vishakhkumar/HyTechAero/README.md

# HyTechAero

Files for HyTech Racing Aero/Composites Team.
For more information, contact me at vkumar@gatech.edu
