vishakhkumar/HyTechAero/3 MeetingNotes/KickoffMeeting.org

# -*- mode: org; -*-

#+TITLE: HyTech Racing Information
#+AUTHOR: Vishakh Pradeep Kumar
#+EMAIL: vkumar@gatech.edu
#+OPTIONS: num:10 whn:10 toc:5 H:100 *:yes ::yes \n:yes ^:yes |:yes

#+HTML_HEAD: <link rel="stylesheet" type="text/css" href="http://www.pirilampo.org/styles/readtheorg/css/htmlize.css"/>
#+HTML_HEAD: <link rel="stylesheet" type="text/css" href="http://www.pirilampo.org/styles/readtheorg/css/readtheorg.css"/>

#+HTML_HEAD: <script src="https://ajax.googleapis.com/ajax/libs/jquery/2.1.3/jquery.min.js"></script>
#+HTML_HEAD: <script src="https://maxcdn.bootstrapcdn.com/bootstrap/3.3.4/js/bootstrap.min.js"></script>
#+HTML_HEAD: <script type="text/javascript" src="http://www.pirilampo.org/styles/lib/js/jquery.stickytableheaders.js"></script>
#+HTML_HEAD: <script type="text/javascript" src="http://www.pirilampo.org/styles/readtheorg/js/readtheorg.js"></script>

* HyTech Racing 
** Location
575 14th St NW, Atlanta, GA 30318.
Google Maps Link -> https://www.google.com/maps/dir//33.786886,-84.406198/@33.786886,-84.406198,17z?hl=en-US

Org sync - apparently used for using rooms. Replaces Jacket pages.

*** Time required to walk to location.
Takes approximately 16 minutes to walk from Woodruff Hall
Takes approximately 23 minutes to walk from Howey Physics Building
You can ask for rides on Slack.

*** Official Address 
575 14th St NW
Atlanta, GA 30318
(850) 888-3232
gthytech@gmail.com
** Jacket Pages (Outdated) - http://jacketpages.gatech.edu/organizations/view/44686
*** Officers
| Jeffrey Ding	  | Team Lead (President) |
| Ayush Jha       | 	Treasurer           |
| Jonathan Rogers | Advisor               |
*** Description
HyTech Racing is a student team at the Georgia Institute of Technology that formed with the intent of competing at the Formula Hybrid International Competition.
The annual Formula Hybrid International Competition is an offshoot from the prestigious Formula SAE Competition.
Hosted by Dartmouth College, it has been held five times starting in 2007 at the New Hampshire Motor Speedway.
From late April to early May, teams from educational institutions around the world bring plug-in hybrid-electric, open-wheeled vehicles to perform in a variety of design and performance challenges.
Design, Endurance, Autocross, and Acceleration events emphasize the importance of a balance between performance and efficiency.
Our team formed in October of 2011 with a daunting goal in mind: to design, build, and test a hybrid vehicle in less than seven months.
In order to accomplish this goal, we apply knowledge learned in the classroom to produce a high-performance, fuel-efficient machine.
The design and build of a HyTech vehicle represents a vastly interdisciplinary process that will test our members on many levels.
The knowledge and skill set that we can gain through a hands-on project will improve our ability to add value to any organizations we become a part of in the future.
We have a designated office and prime warehouse space in Georgia Tech’s Student Competition Center where we will design and build our vehicle.

The primary objectives for HyTech Racing are as follows: 
- Provide hands-on engineering and organizational experience 
- Allow students to seek creative solutions for performance and efficiency in motor vehicles 
- Produce a competitive hybrid vehicle for the team’s first event that can be improved in coming years

*** Description Details
- Tier: III
- Organization Contact: Jeffrey Ding
- External Website: http://hytechracing.gatech.edu
- Meetings: Tuesday & Thursdays @ 6:30pm, Sundays @ 4pm
- Dues: $50 per semester

** OrgSync - https://orgsync.com/136388/chapter
*** Portal Information
**** Description
We are an award-winning electric vehicle racing team at Georgia Tech.
We participate in the annual Formula Hybrid (Electric Class) and FSAE Electric competitions which take place in Loudon, New Hampshire and Lincoln, Nebraska respectively.
Designing the car, working with a team, learning manufacturing tools and techniques techniques, and innovating with new technologies are all part of the experience!
Our core values are Innovation, Sustainability, Education, and Excellence.

**** Category
Recreation/Leisure
**** Website
http://hytechracing.gatech.edu/
**** Primary Student Organization Leader Position Title
Team President
**** Primary Student Organization Leader
Jeff Ding
***** Georgia Tech Email
jeffding@gatech.edu
**** Finance Officer Title
Treasurer
**** Finance Officer Name
Mike Yan
***** Georgia Tech Email
mike.yan@gatech.edu
**** Selection Process/Membership Requirements
To become a member of HyTech Racing, we ask that you:
- come to the meetings
- pay dues ($50 / semester)
- receive appropriate training
- and show a healthy interest in what we do!
**** Meeting Day
Sunday, Tuesday and Thursday
**** What are three goals your organization has for this year?
- Win our competitions 
- Be a good learning experience for new members 
- Start early on next year's car and improve upon this year's car

** Old Website - http://dcaplan3.wixsite.com/hytech-racing/about_us
*** The Competition
The way we move around the world is changing.  
As global warming, diminishing petroleum resources, and air pollution make traditional internal combustion vehicles less attractive every day, the race for effective solutions is on.
To foster learning and creative processes toward this problem, international educational institutions and corporations alike are promoting unique challenges that encourage students to design and build modern vehicles.
SAE International is perhaps the most important agent in promoting such challenges.

The annual Formula Hybrid International Competition is an offshoot from the prestigious Formula SAE Competition.
Hosted by Dartmouth College, it has been held every year since its founding in 2006 at the New Hampshire Motor Speedway.
In late April to early May, teams from educational institutions around the world bring plug-in hybrid-electric, open-wheeled vehicles to perform in a variety of design and performance challenges.
Design, Endurance, Autocross, and Acceleration events emphasize the importance of a balance between performance and efficiency.
*** Who We Are
HyTech Racing is Georgia Tech’s first and only team created to participate in the Formula Hybrid Competition.
Our team’s formation began with the election of a Project Lead and Chief Engineer on September 28, 2011.
Our goal is to address the challenges presented by the competition while learning how to design, build, and optimize advanced machines.
We also embrace the opportunity to gain experience in leadership, communication, business development, and effective time management throughout the course of the project.

The design and build of a “HyTech” vehicle represents a vastly interdisciplinary process that will test our members on many levels, and make them more prepared to face real-world challenges in the workplace after graduation.
The knowledge and skill set that we can gain through a hands-on project where a student-run group acts as an entire business unit will improve our ability to add value to whatever organizations we may become a part of in the future.
While an education in the classroom is necessary, an education in this team environment can teach us lessons far beyond the scope of traditional learning.

We have a designated workplace in Georgia Tech’s new, coveted Student Competition Center, with plenty of space and resources to design and build our vehicle inside prime warehouse space and our private office.
Other Georgia Tech automotive teams have adjacent spaces at our Student Competition Center, including GT Motorsports, Wreck Racing, and the Solar Jackets.
These teams have a long history of continued excellence in competition, and we plan to build upon this legacy.

*** Meetings
The team meets every Tuesday and Thursday at 7:00 PM at the Student Competition Center (SCC).
Additionally the team meats on Sundays at 4:00 PM.
The Student Competition Center can be accessed via the Stinger Green Route, the Stinerette, or a ride from any team member.

*** Photo Gallery
Photos with brief descriptions underneath. 
Can be accessed at http://dcaplan3.wixsite.com/hytech-racing/news_and_photos
** New Website - https://hytechracing.gatech.edu
*** Front Page
HyTech Racing, a student-run organization at the Georgia Institute of Technology, is dedicated to the design and development of an electric vehicle for the Formula SAE Electric and Formula Hybrid Electric series.

At HyTech Racing, our goal is to gain a deep understanding of all aspects of vehicle design and development. Each member of our team has a chance to learn about all components of vehicle design and production through research, CAD design, machining, component sourcing, project management, manufacturing and testing.

*** Cars 
**** 2016
This year HyTech designed and built our vehicle to compete in both Formula Hybrid and Formula SAE Electric competitions.

***** Chassis Details
- Completely new team-designed frame
- Torsional stiffness FEA: 2550 ft.lb/deg
- MDF jig designed for efficient and accurate chassis welding

***** Driveline Details
- Motor output (front) sprocket and rear sprocket designed and machined in-house
- Front sprocket machined out of Aluminum 2024 to reduce weight (versus Steel) while maintaining a factor of safety >1
- Hard mounted differential carriers machined out of Aluminum 6061; sticking to a robust and tested design
- Motor mount manufactured from Steel 4041- reduces stress points, holds up to the maximum torque
- Powered by the Enstroj Emrax 207 which is lighter than the other options in the market, yet powerful enough to handle the load of the car

***** Mechanical Controls Details
- Steering
  + Custom 6061-T6 rack housing allows for low friction rack translation
  + 32x force magnification from steering wheel to steering rack
  + ~5° steering free play
  + 32° of steering
- Brakes
  + Adjustable pedal position for better ergonomics
  + Manufactured with aluminum for decreased weight

***** Suspension Details
- Short 65" wheelbase for lower polar moment of inertia
- 52" track width reduces lateral weight transfer and increases lateral force produced by the tires when cornering
- Steering rods aligned to have just 0.1° of steer for two inches of wheel displacement
- Uprights and hubs CNC machined in-house.
- Hubs designed to be interchangeable between left and right corners
- Camber adjustable from 0° to -5.0° by use of threaded washers at the upper A arm point
- Suspension designed to keep outside wheels at a 0° of camber under the maximum allowable body roll of 2° when cornering.

***** Electrical Controls Details
- Modular system of boards allows for easier development and replacement of controls system components
- Electrical boards designed using EAGLE CAD, then manufactured on campus by team members using printed circuit board milling
- Arduino software developed by team members and shared publicly as open source
- Aluminum battery enclosure and front controls enclosure created using water-jet and in-house welding
- Arduinos communicate with motor controller and battery management system entirely over CAN Bus network
- Real-time data is read by the Arduinos and sent to a steering wheel display

***** High Voltage System Details
- Emrax 207 Medium Voltage motor powers the drivetrain
- Rinehart PM100DX Motor Controller controls the Emrax motor
- Orion Battery Management System tracks cells
- Single accumulator container holds all batteries and most high-voltage components
- 4 team-packaged accumulator segments hold 82 LiFePo4 cells in series

**** 2015
Not much information given except for some pictures.
**** TODO 2014 - Why no mention?
No mention at all. Not sure why. 
**** 2013
Available at old site. Not much information given. Pictures of CAD models are available.

*** Team Members - 2016
Probably going to change. Keep in mind.
Last updated: <2016-09-02 Fri>
**** Faculty Advisor

Dr. Jonathan Rogers — Mechanical Engineering

**** Officers
Jeffrey Ding — President

Ayush Jha — Treasurer

Nathan Cheek — Operations

**** Engineering Leadership

Jarrett Schalch — Chief Engineer

Siddarth Sreeram — Mechanical Systems Team Lead

Nathan Cheek — Electrical Systems Team Lead

**** Team Members
***** Brake System 

Trevor Davidson

Eric Huang

Sai Narra

***** Business Team 

Mike Yan - Lead

Ayush Jha

Chasis Team 

Max Hertlein — Lead

***** Circuits Team

Nathan Cheek — Lead

Simon Anni

Arpan Bhavsar

Charith Dassanayake

Chidinma Imala

Brian Kaplan

Chinmay Kulkarni

Aaron Mebane

Nikhil Ramesh

***** Composites Team

Russell Sprouse — Lead

Wale Agoro

Rahul Brahmal

Carson Brial

Ayush Jha

Utkarsh Pandey

Hardik Sangwan

***** Drivetrain Team

Jacob Hogenkamp — Lead

John Allen Dyer

Bhavesh Singh

***** Manufacturing Team

John Arroyave — Lead

Conrad Hanson

***** Programming Team

Andrew Renuart — Lead

Victor Chen

Ryan Gallaway

Nikhil Ramanan

Shashank Singh

***** Steering System Team

Michael Phillips — Lead

Kamil Molwani

John Wennerstrum

Charles Xiao

***** Suspension System Team

Siddarth Sreeram — Lead

Conner Chadwick

Zan Stone

*** Sponsors - https://hytechracing.gatech.edu/sponsors/
Pictures of the sponsors and hyperlinks to their website.

** Competitions you go to 
*** Formula Hybrid
**** Website - http://www.formula-hybrid.org
**** Location - 
**** Rules and Deadlines (2017)
***** Website Link - http://www.formula-hybrid.org/students/rules-and-deadlines/
***** PDF Link - http://www.formula-hybrid.org/wp-content/uploads/2017-Formula-Hybrid-Rules-Rev-1.pdf
Also available in the HyTech folder. Visit [[/Users/vishakhkumar/Desktop/Notes/HyTech/2017-Formula-Hybrid-Rules-Rev-1.pdf][2017-Formula-Hybrid-Rules-Rev-1.pdf]].
***** 2017 Action Deadlines

|-------------------------------------------+---------+------------|
| 2017 ACTION DEADLINES                     | Acronym |        DUE |
|-------------------------------------------+---------+------------|
| Structural Equivalency Spreadsheet        | SES     |   10.31.16 |
| Project Management Plan                   |         |   11.04.16 |
| Electrical System Form 1                  | ESF-1   |   11.11.16 |
| Fuel Request                              |         |   12.09.16 |
| Program Information Sheet                 |         |   12.09.16 |
| Interim Project Report                    |         | 	02.03.17 |
| Impact Attenuator Data                    |         | 	02.10.17 |
| Site Pre-Registration                     |         |   02.17.17 |
| Electrical System Form 2                  | ESF-2   | 	02.24.17 |
| Failure Modes and Effects Analysis        | FMEA    | 	02.24.17 |
| Design Report                             |         |   03.22.17 |
| Sustainability Report                     |         | 	03.22.17 |
| Design Specifications Sheet               |         |   03.22.17 |
|-------------------------------------------+---------+------------|

***** Action Deadline Submissions
Please allow 24 hours for updates during the normal business week.
Contact Formula Hybrid at info@formula-hybrid.org if you suspect an error in the date or time of your submission.
***** 2017 Registration
- Opens for Hybrid and HIP category on Wednesday, October 5, 2016 10:00 AM EDT
- Opens for Electric category on Wednesday, October 12, 2016 10:00 AM EDT
- Opened for entry of a 2nd team vehicle on Wednesday, October 19, 2015 10:00 AM EDT

- Closes on Wednesday, October 26, 2016 11:59 PM EST

Important: The 21-day registration period is much shorter than in previous years.  Register Early!

***** Vehicle Categories
Formula Hybrid has three vehicle categories: Hybrid, Hybrid-In-Progress (HIP), and Electric-only.
****** Hybrid 
The Hybrid category is the most challenging of all the SAE Collegiate Design Series engineering competitions, typically requiring thousands of hours of engineering and development time.
****** HIP
HIP is for hybrids that are still under development, such as a two-year design and build cycle.
Hybrid-In-Progress vehicles can be driven on electric power.
****** Electric-only
Electric-only is for vehicles designed for battery/electric drive, and closely parallels the new FSAE Electric rules.
Student teams wishing to enter a FSAE Electric vehicle in the Formula Hybrid Electric-only class should be aware that there are some rules that are different.
Read all of the rules carefully!

***** Rules
Refer Formula Hybrid Rules

*** FSAE Lincoln - Lincoln

** Competition rule
*** Static Test
**** Cost
**** Design
**** Business Pres
- Formula Hybrid -> Project management
- FSAE -> Business case and try to sell to sponsors
- Cost report needed on both
*** Dynamic Test
**** Acceleration 
  Fastest in a straight line. Tests strength and drag.
**** Skidpad
Drive the car in a figure-8. Tests suspension.
**** Autocross
Drive in preset track and tests everything.
**** Endurance
- 44 kilometres <- Hybrid
- 22 kilometres <- Lincoln

Tests durability of car and driver

*** Test
- Driver egress
- brake test
- tilt test 
- Rain test
**** Electrical scrutineering
**** Mechanical Scrutineering
** Car info
0-60 mph in 3 sec
*** Electrical system
**** High voltage
Deals with battery pack and safety features
Lierally manufacture the battery packs made from LiPo. Test and check before actual use.
Battery Management system.

*** Mechanical System

Looking for a decent machining team 

**** Chassis
**** Suspension
Belt cranks/pivot
Helps out with CNC shit.
Powder-coat the chasis this year, used paint last year.
**** Driver Controls
**** Manufacturing/Machining
Learn how to use the toys in the Invention studio.
Actually weld stuff.
***** HASS CNC Router ?
***** TIG welding

*** Business Team 
You don't have to be a business major.
**** Finances 
**** Sponsorship
**** PR and outreach
**** Project Management
**** Operations and Logistics
**** Recruiting

** Self-imposed Deadlines
*** Oct 11 - rolling car
*** Dec 26 - running car
*** Mar 24 - competition ready car

* Meeting One <2016-09-06 Tue>
** Pseduo-kickoff stuff?
Apparently people haven't been to the morning.

** Stuff Jared read on the board.
*** Chasis 
**** FEA Harness bar
**** Impact Attenuator
*** Suspension
**** FEA all brakes stuff
*** Controls
**** Steering - hasn't been solved.
**** Brakes - Dylan
***** Pedal box
*** Driveline
**** Planetary box

* Meeting Two <2016-09-08 Thu>
** TODO Install Solidworks 2016 and boot camp. Ask OIT to help out.
** TODO Pay dues on Sunday
** TODO Ask for composite textbooks and watch videos
** TODO Go to the invention studio and get water jet training
** TODO Install OMAX - water jet.
** TODO Check PI training
** TODO Get slack access
** TODO get drive access and make a proper directory
** TODO check groupme for instr.

* Slack
Name: Vishakh Kumar
Username: vkumar
Password: Himym@123

* Meeting Three
** Location of the file you're looking for
*** Location - HyTechRacing/DirtyDelilah/Controls/Ergo
*** Files
- C.seat.sldprt
- C.SeatMold.sldprt
*** Instructions
- Optional - Change the axis orienttion.
- Top should have rectangular slabs vertically
- Bottom should be horizontal.
- Split just above the rear upward part.

*** Solidworks split tool?
