vishakhkumar/HyTechAero/4 F2016 Aerodynamics/Aero Design Board.pptx

Aerodynamics

Design Goals

- Maximize overall downforce
- Minimize static weight of system
- Balance CoP ~55% rearward to maintain stability under braking
- Minimize drag

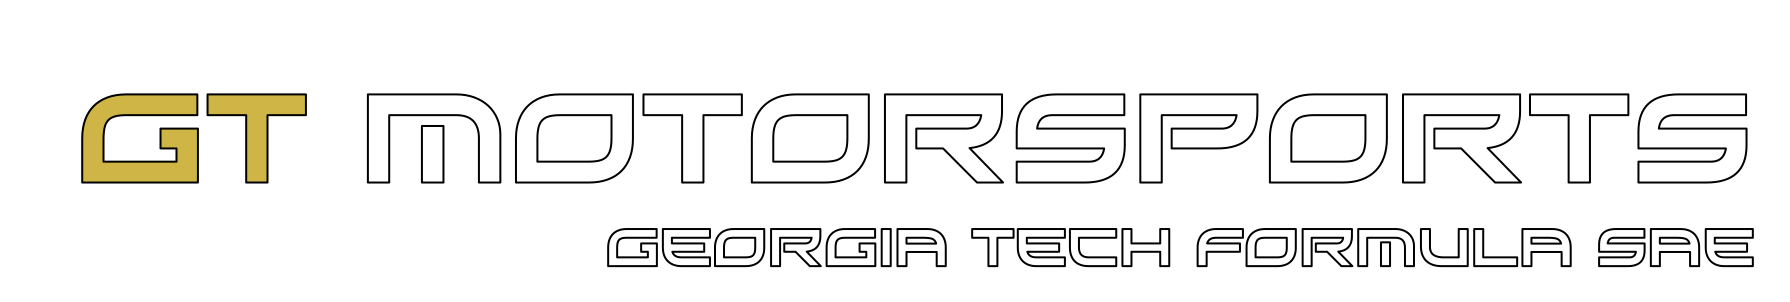
[picture p3: figure]
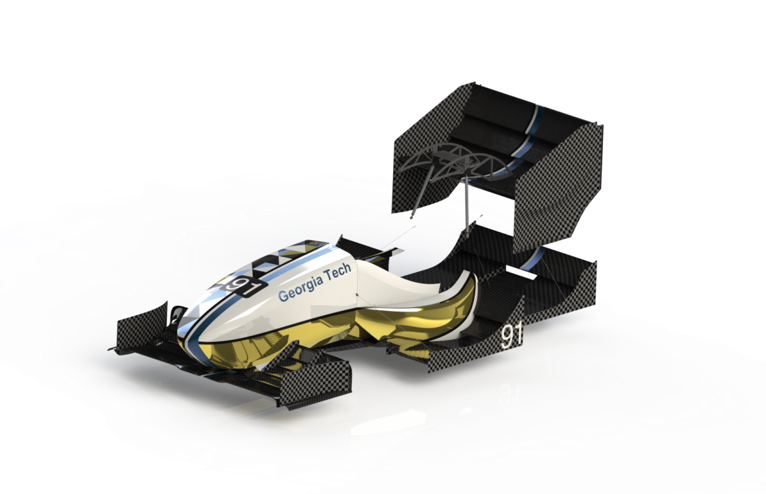
[picture p4: figure]

Features

- Concave rear wing endplates
  - Add 10lb downforce at 40mph
- Swan neck mounting design
- Multi element front wing
- Airfoil integrated into undertray
- Side wings

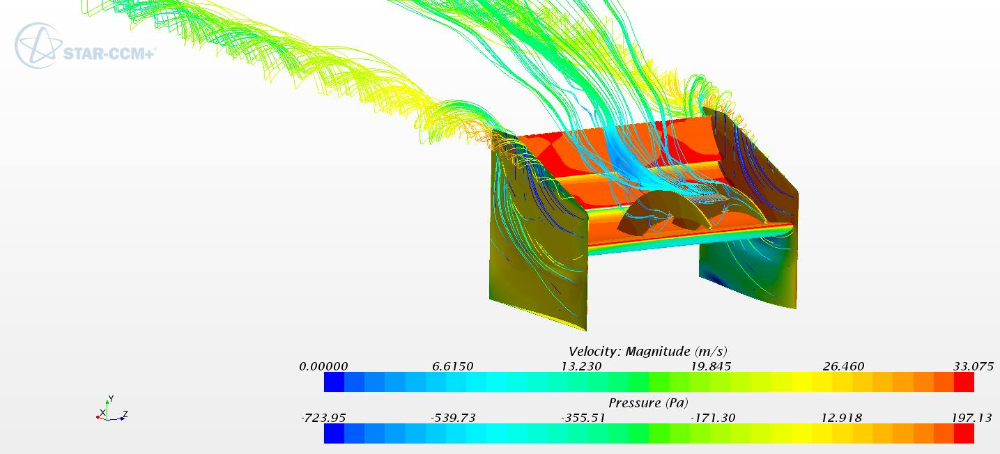
[picture p5: figure]

RW 3D CFD simulation (40 mph)

FW endplate CFD simulation (40 mph)

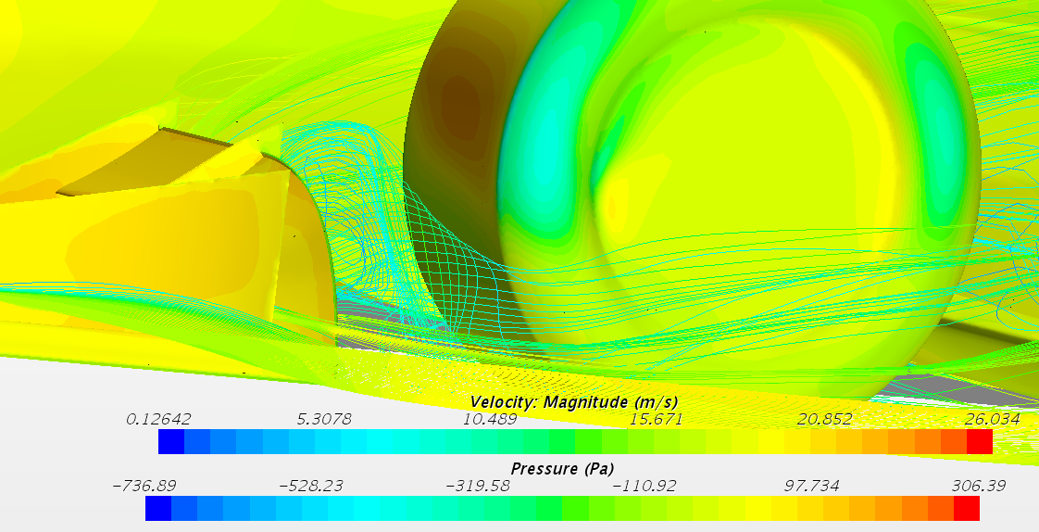
[picture p6: figure]
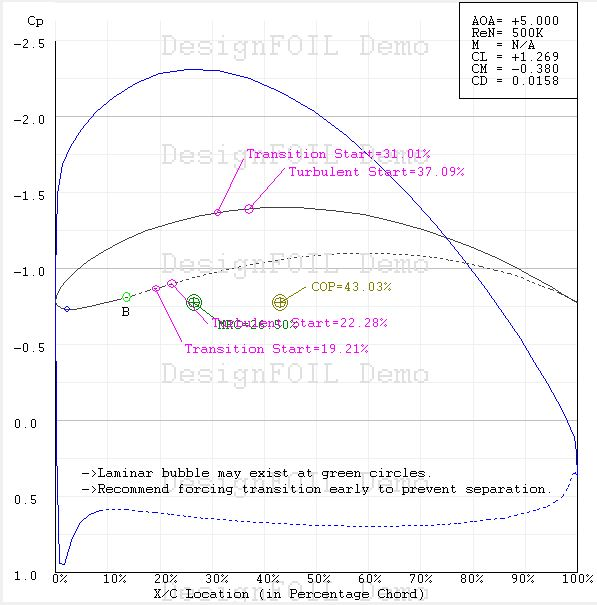
[picture p7: figure]

RW main plane DesignFOIL simulation

RW main plane 2D CFD simulation (40 mph)

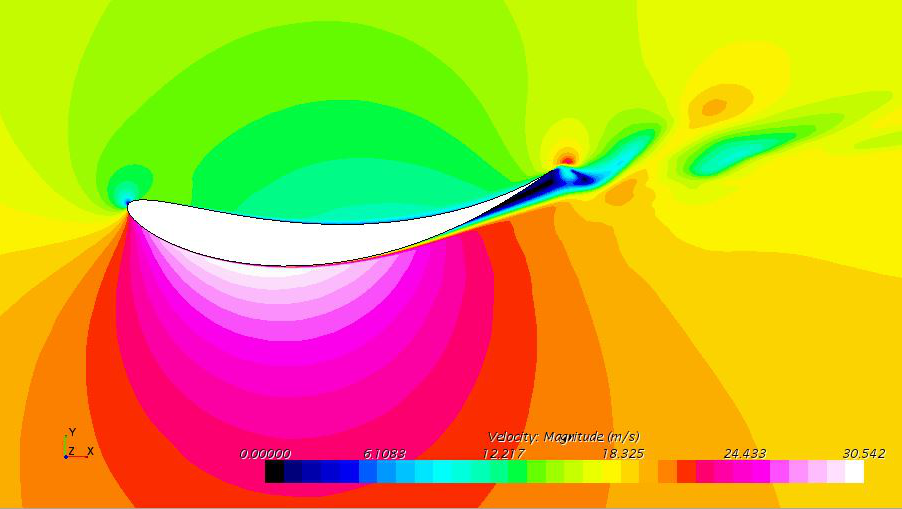
[picture p8: figure]

CFD Overview

- 40 mph
- SST k-omega turbulence model
- Rolling tires and moving ground plane
- Mesh size: 8M cells
- Total downforce: 776N with Cl = -2.84
- Total drag: 304N with Cd = 1.28
