vishakhkumar/HyTechAero/3 MeetingNotes/Bill of Materials.xlsx

Part | Order | Manufacture process | Tool Used | EPS/MDF | Sheets required | Scotty Principle
Undertray | 1.1 | Tri Split Mold w/ plug | 5-axis waterjet | EPS
Nosecone | 1.2 | Tri Split Mold w/ plug | 5-axis waterjet | EPS | 50 | 5
Close out | 1.3 | Single Mold w/ plug | 5-axis waterjet | EPS
Front Wing A | 2.1 | Bi Split Laminate | 3-axis waterjet | EPS | 16 | 5
Front Wing B | 2.2 | Bi Split Laminate | 3-axis waterjet | EPS | 5 | 2
Front Wing B Mirror | 2.2 | Bi Split Laminate | 3-axis waterjet | EPS | 5 | 2
Front Wing C | 2.3 | Bi Split Laminate | 3-axis waterjet | EPS | 5 | 2
Front Wing C Mirror | 2.3 | Bi Split Laminate | 3-axis waterjet | EPS | 5 | 2
Rear Wing A | 3.1 | Bi Split Laminate | 3-axis waterjet | EPS | 10 | 5
Rear Wing B | 3.2 | Bi Split Laminate | 3-axis waterjet | EPS | 10 | 5
Rear Wing C | 3.3 | Bi Split Laminate | 3-axis waterjet | EPS | 10 | 5
Right Front Endplate | 4.1 | Peel Off Laminate w/ plug | CNC mill | MDF | 2 | 1
Left Front Endplate | 4.1 | Peel Off Laminate w/ plug | CNC mill | MDF | 2 | 1
Left Rear Endplate | 5.1 | Peel Off Laminate w/ plug | CNC mill | MDF | 2 | 1
Right Rear Endplate | 5.1 | Peel Off Laminate w/ plug | CNC mill | MDF | 2 | 1
Right Front Endplate Exterior | 6.1 | 3d-Print | Markforged | N/A | 0 | 0
Left Front Endplate Exterior | 6.1 | 3d-Print | Markforged | N/A | 0 | 0
