vishakhkumar/HyTechAero/4 F2016 Aerodynamics/0 AERO ORDERS.xlsx

Aero Orders
Received? | Date placed | Company | Item(s) | Total cost | Notes
Yes | 2016-03-09 | Buy Metal | Aluminum for fish, bodywork | $144.74 | SGA
Yes | 2016-03-05 | Amazon | Oleic acid, green powder | $27.98
Yes | 2016-02-26 | Amazon | DP420 gun | $55.63
Yes | 2016-02-20 | Aircraft Spruce | Rivets | $4.80
Yes | 2016-02-19 | Amazon | Titanium Dioxide | $7.99
Yes | 2016-02-17 | McMaster | New snaps (for cable) | $9.62
Yes | 2016-02-12 | Amazon | DP420 and silicone | $155.92
Yes | 2016-02-10 | Buy Metal | Aluminum angle | $43.26
Yes | 2016-02-10 | Online Metals | Aluminum plate | $8.05
Yes | 2016-02-06 | Aircraft Spruce | Camlocs | $188.46
Yes | 2016-02-04 | McMaster | Pins and cable supplies | $86.88 | Return big snaps?
Yes | 2016-01-25 | Formula World Racing | Prepreg | $1920.00 | SGA
Yes | 2016-01-02 | RAMPF | Tooling board | $1137.50
Yes | 2015-11-15 | Rock West | Carbon plate | $425.09
Yes | 2016-02-12 | DFL Jake | Machining | $ X.YZ | Alotted $3,500.00
Yes | 2016-02-08 | Brooks CNC Routing | Machining | $700.00 | Make sure he has been paid
 |  |  | TOTAL: | $4915.92
