vishakhkumar/HyTechAero/1 1 Front Aerodynamic Devices/FrontAssembly.SLDASM

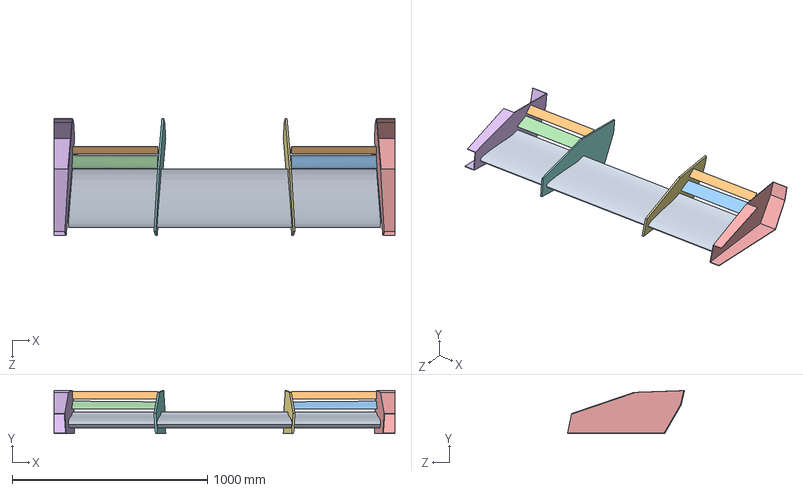
[picture p10: CAD file, 2017-02-19]
1 1 Front Aerodynamic Devices/FrontAssembly.SLDASM
1746.9 x 221.0 x 600.1 mm
FrontA
FrontC x 2
FrontB
MirrorB
FrontEndplate
MirrorFrontEndplate
FrontEndplateInner
MirrorFrontEndplateInner
