vishakhkumar/HyTechAero/1 1 Rear Aerodynamic Devices/RearAssem.SLDASM

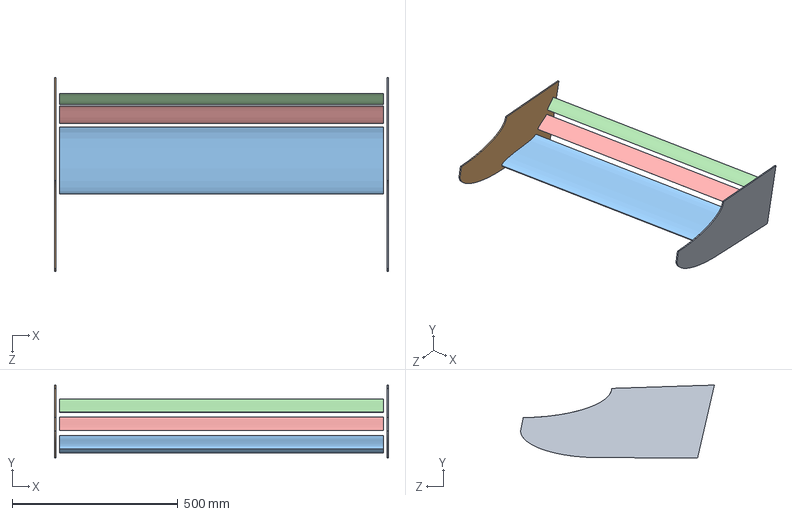
[picture p11: CAD file, 2017-02-07]
1 1 Rear Aerodynamic Devices/RearAssem.SLDASM
1007.0 x 219.8 x 584.5 mm
RearEndplate
MirrorRearEndplate
RearA
RearB
RearC
