vishakhkumar/HyTechAero/1 1 Rear Aerodynamic Devices/RearEndplate/RearEndplateAssem.SLDASM

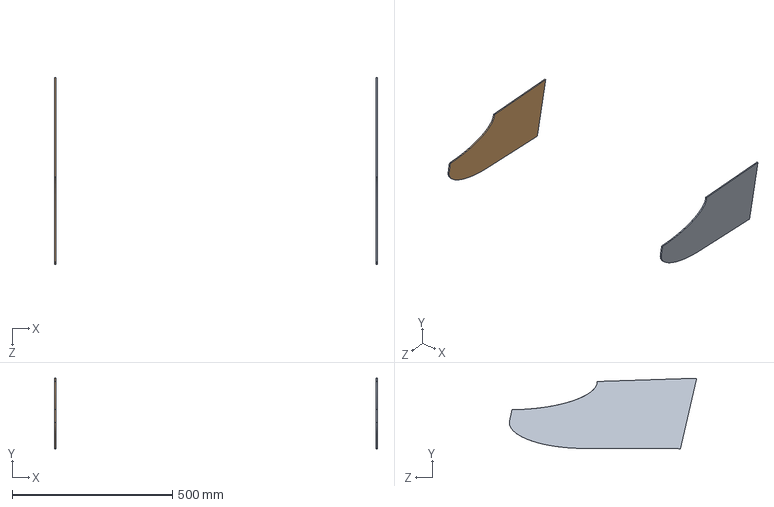
[picture p12: CAD file, 2017-02-21]
1 1 Rear Aerodynamic Devices/RearEndplate/RearEndplateAssem.SLDASM
1007.0 x 219.8 x 584.5 mm
RearEndplate
MirrorRearEndplate
