vishakhkumar/HyTechAero/2 3 Undertray/UndertrayAssem.SLDASM

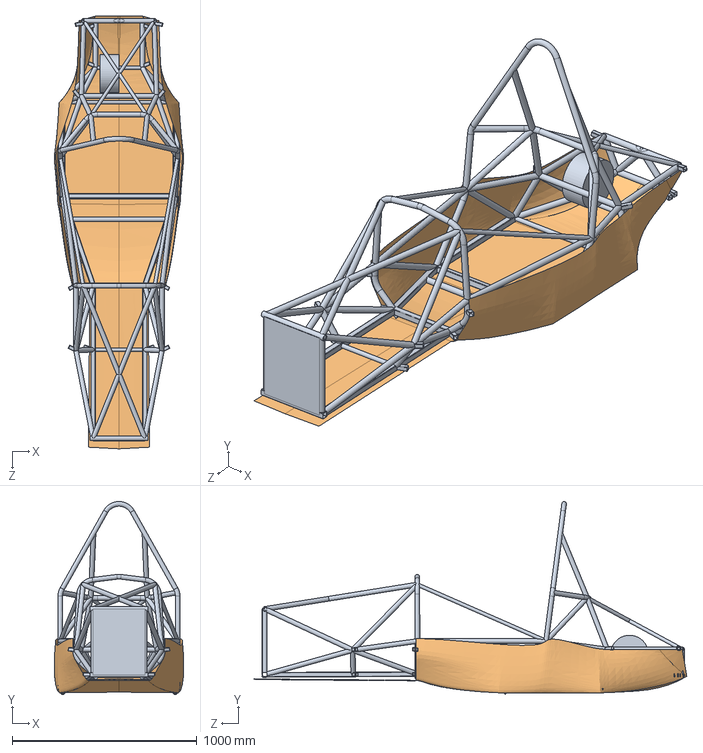
[picture p13: CAD file, 2017-02-21]
2 3 Undertray/UndertrayAssem.SLDASM
699.4 x 1043.3 x 2338.8 mm
F.FrameFinal 10-12-16
Undertray
