vishakhkumar/HyTechAero/Aerokit.SLDASM

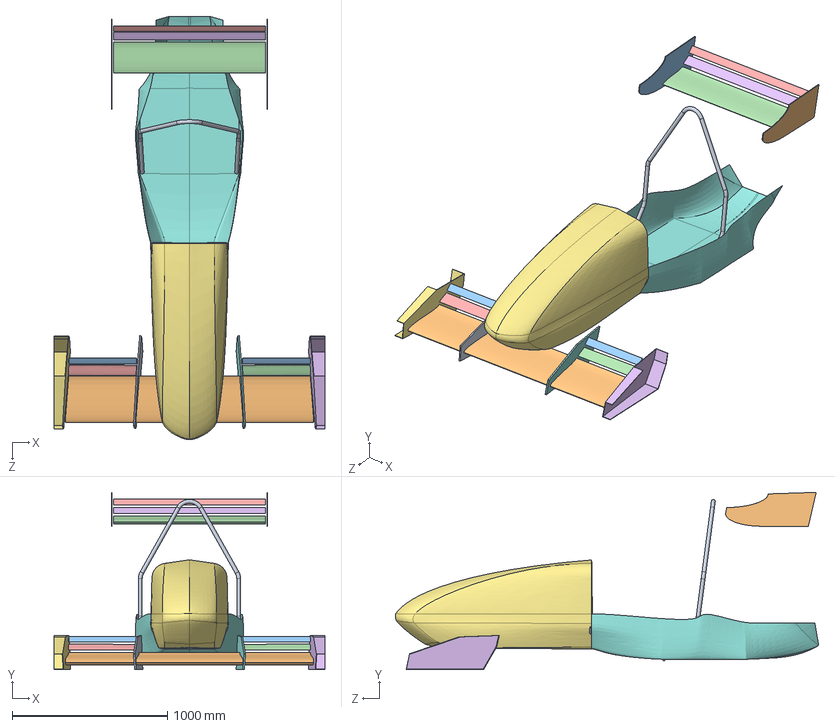
[picture p14: CAD file, 2017-02-21]
Aerokit.SLDASM
1746.9 x 1143.0 x 2729.6 mm
F.FrameFinal 10-12-16
FrontA
FrontC x 2
FrontB
MirrorB
FrontEndplate
MirrorFrontEndplate
FrontEndplateInner
MirrorFrontEndplateInner
RearEndplate
MirrorRearEndplate
RearA
RearB
RearC
NoseCone
Undertray
