vishakhkumar/HyTechAero/2 1 Nosecone/NoseConeAssembly.SLDASM

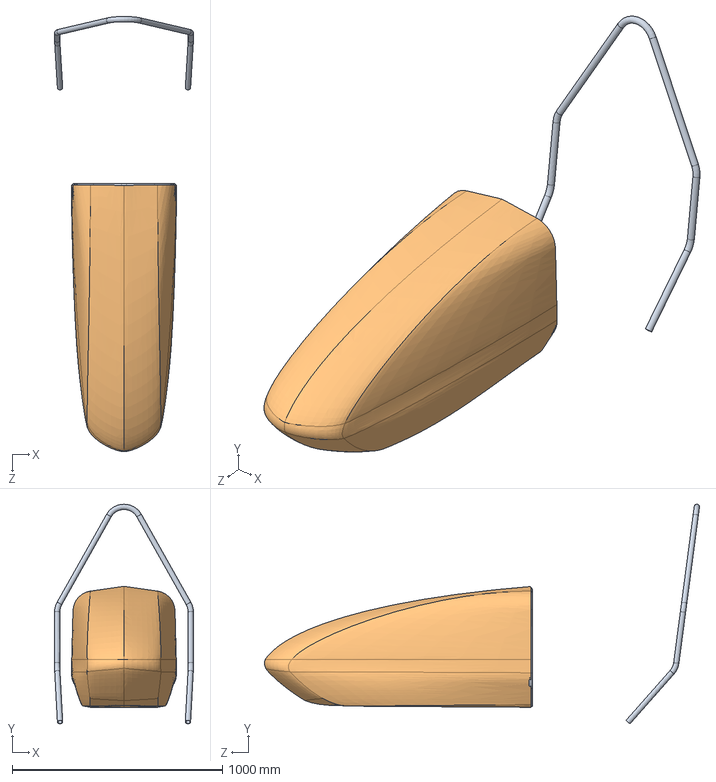
[picture p15: CAD file, 2017-02-21]
2 1 Nosecone/NoseConeAssembly.SLDASM
660.4 x 1043.3 x 2066.6 mm
F.FrameFinal 10-12-16
NoseCone
