vishakhkumar/HyTechAero/4 F2016 Aerodynamics/Final RW/F16_AE_RearWing_AirfoilsAssembly.SLDASM

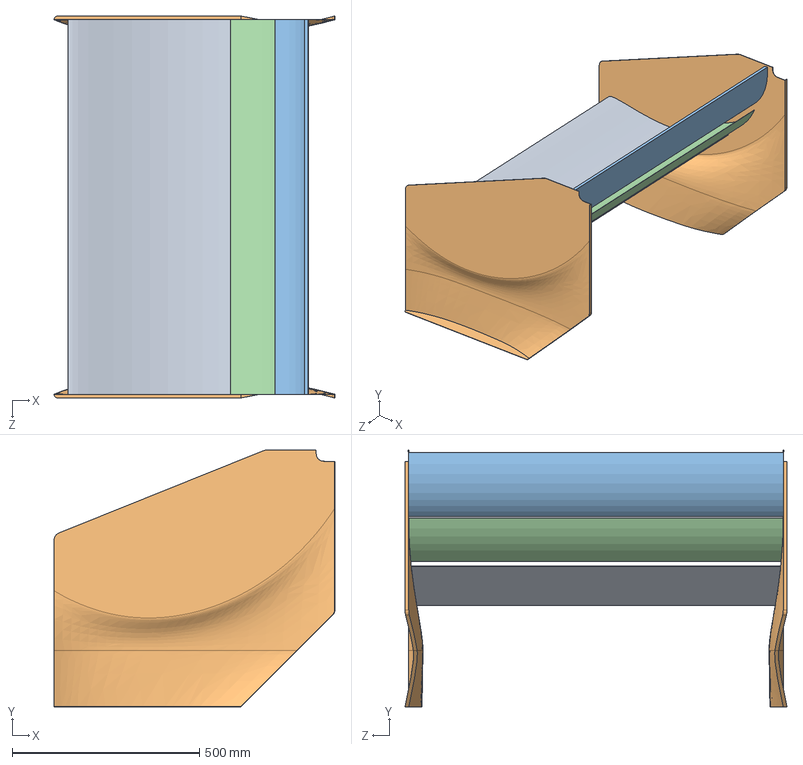
[picture p16: CAD file, 2016-12-03]
4 F2016 Aerodynamics/Final RW/F16_AE_RearWing_AirfoilsAssembly.SLDASM
750.0 x 686.0 x 1020.0 mm
F16_AE_RearWing_MainPlane
F16_AE_RearWing_Endplates
F16_AE_RearWing_FlapWithGurney
F16_AE_RearWing_Flap
