vishakhkumar/HyTechAero/1 1 Rear Aerodynamic Devices/RearWing/RearWings.SLDASM

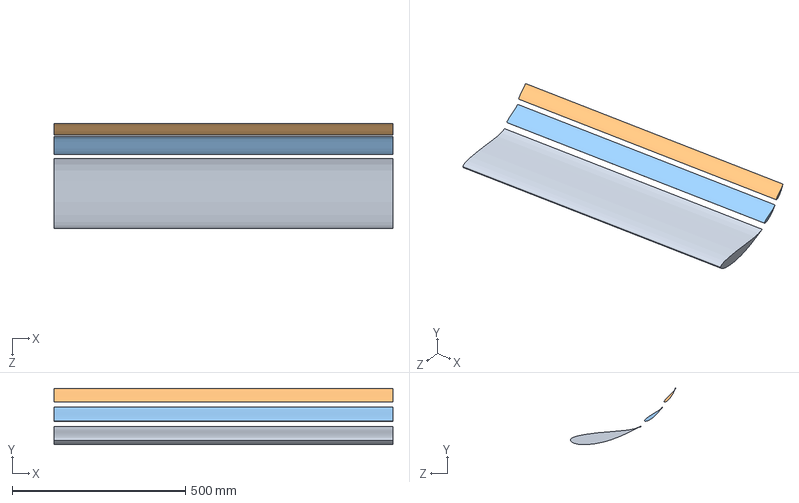
[picture p17: CAD file, 2017-02-21]
1 1 Rear Aerodynamic Devices/RearWing/RearWings.SLDASM
977.0 x 162.6 x 303.1 mm
RearA
RearB
RearC
