vishakhkumar/HyTechAero/2 2 Close Out/AssemblyForCloseoutMold.SLDASM

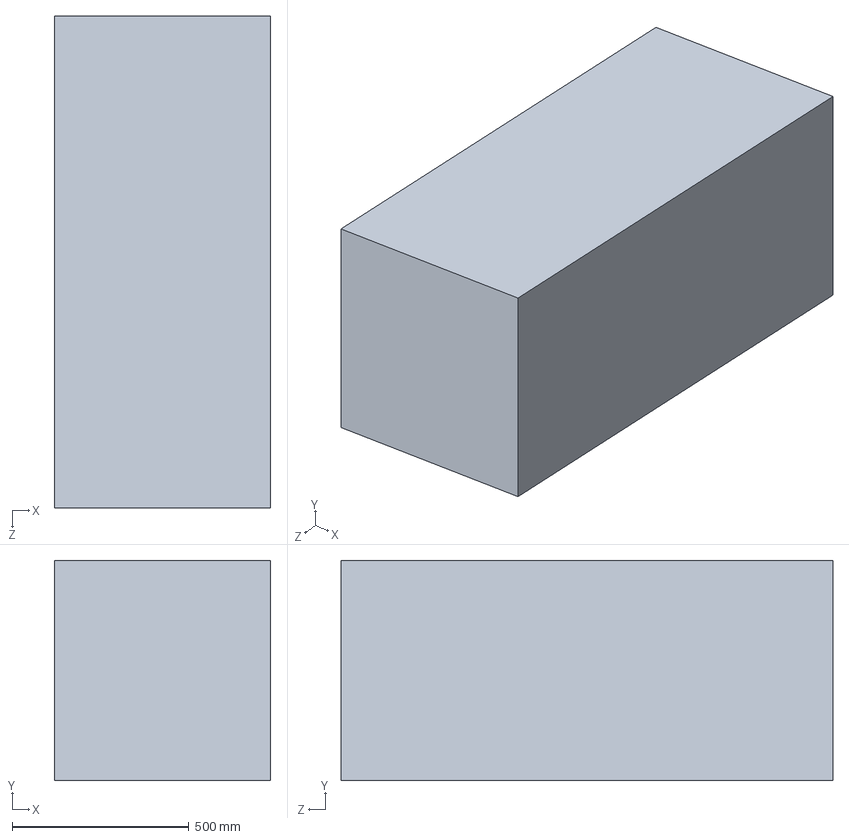
[picture p18: CAD file, 2017-02-21]
2 2 Close Out/AssemblyForCloseoutMold.SLDASM
610.6 x 623.3 x 1390.7 mm
