vishakhkumar/HyTechAero/4 F2016 Aerodynamics/1-16-16 Assembreeee.SLDASM

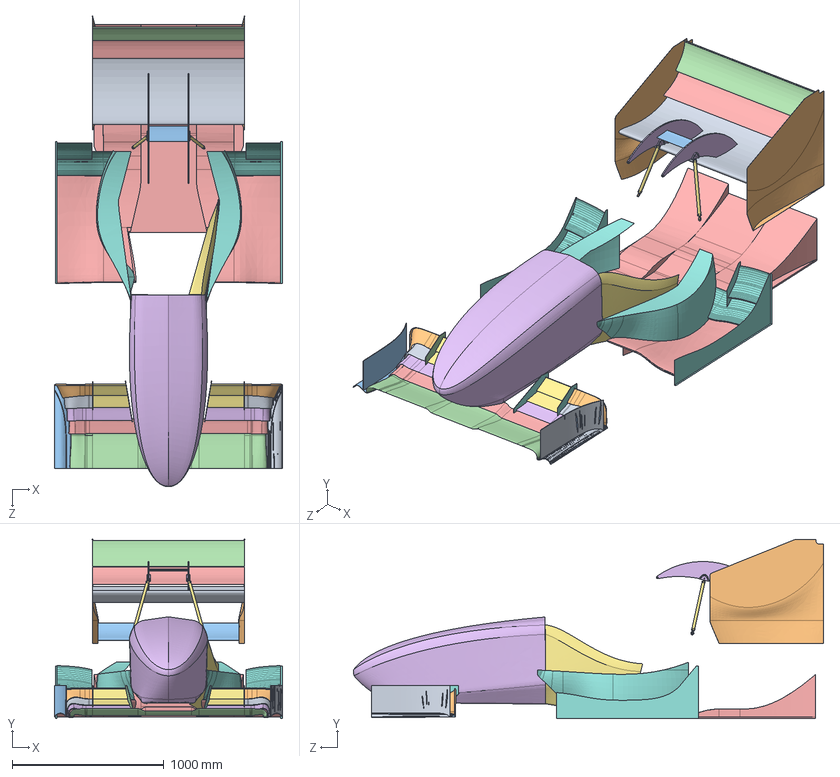
[picture p19: CAD file, 2016-12-03]
4 F2016 Aerodynamics/1-16-16 Assembreeee.SLDASM
1502.5 x 1181.3 x 3099.3 mm
10.4 joukowsky 0.08 thick 0.25 camber
3D endplate new
beam wing
joukowsky 0.08 0.25 flap with 10mm gurney
joukowsky 0.08 0.25 flap
swan neck
carbon rods
ASM-4T Ball x 4
ASM-4T Rase x 4
ASM-4T Case x 4
new swan neck flap
FW8 main
flap 1
FW8 F2
Imported4
Imported5
Imported6
Top EP
Imported8
Imported9
Floor2
Ver8
Close Out Ver 1
sidepod6.1
