vishakhkumar/HyTechAero/1 1 Front Aerodynamic Devices/FrontEndplate/FrontEndplateAssem.SLDASM

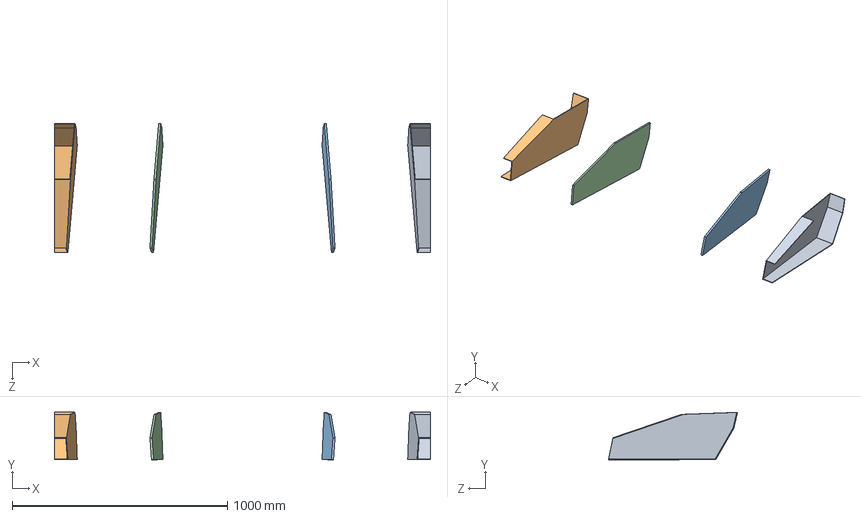
[picture p20: CAD file, 2017-02-21]
1 1 Front Aerodynamic Devices/FrontEndplate/FrontEndplateAssem.SLDASM
1746.9 x 221.0 x 600.1 mm
FrontEndplate
MirrorFrontEndplate
FrontEndplateInner
MirrorFrontEndplateInner
