vishakhkumar/HyTechAero/1 1 Front Aerodynamic Devices/FrontWing/FrontWingAssem.SLDASM

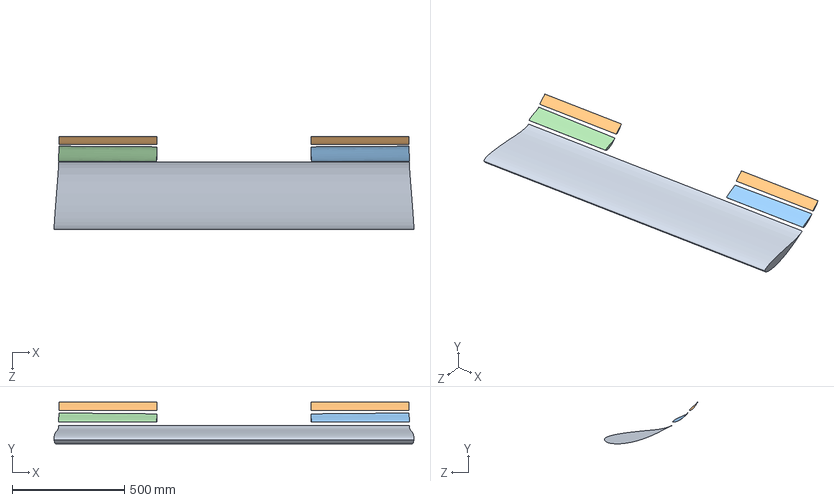
[picture p21: CAD file, 2017-02-19]
1 1 Front Aerodynamic Devices/FrontWing/FrontWingAssem.SLDASM
1600.9 x 186.1 x 414.6 mm
FrontA
FrontC x 2
FrontB
MirrorB
