vishakhkumar/HyTechAero/4 F2016 Aerodynamics/F16_AE_SidePodsAssembly.SLDPRT

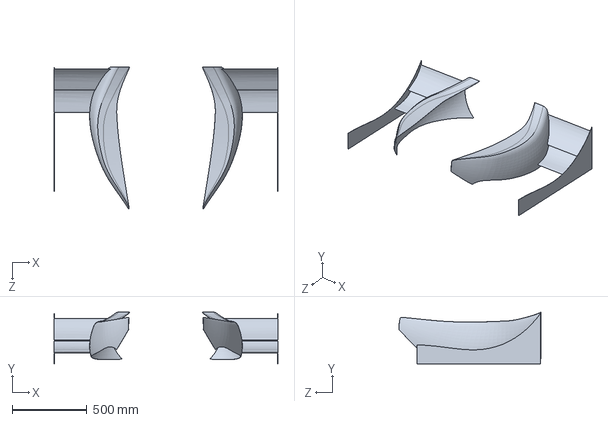
[picture p22: CAD file, 2016-12-03]
4 F2016 Aerodynamics/F16_AE_SidePodsAssembly.SLDPRT
1502.0 x 347.7 x 954.5 mm
