vishakhkumar/HyTechAero/2 2 Close Out/AssemForRightCloseoutMold.SLDASM

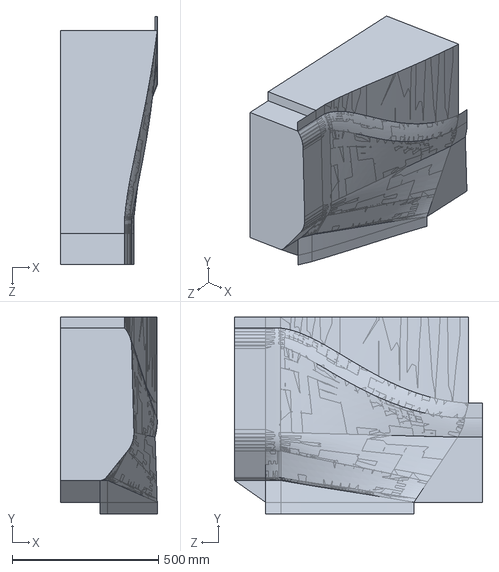
[picture p23: CAD file, 2017-02-21]
2 2 Close Out/AssemForRightCloseoutMold.SLDASM
330.4 x 673.1 x 847.7 mm
