vishakhkumar/HyTechAero/4 F2016 Aerodynamics/F16_AE_Assembly.SLDASM

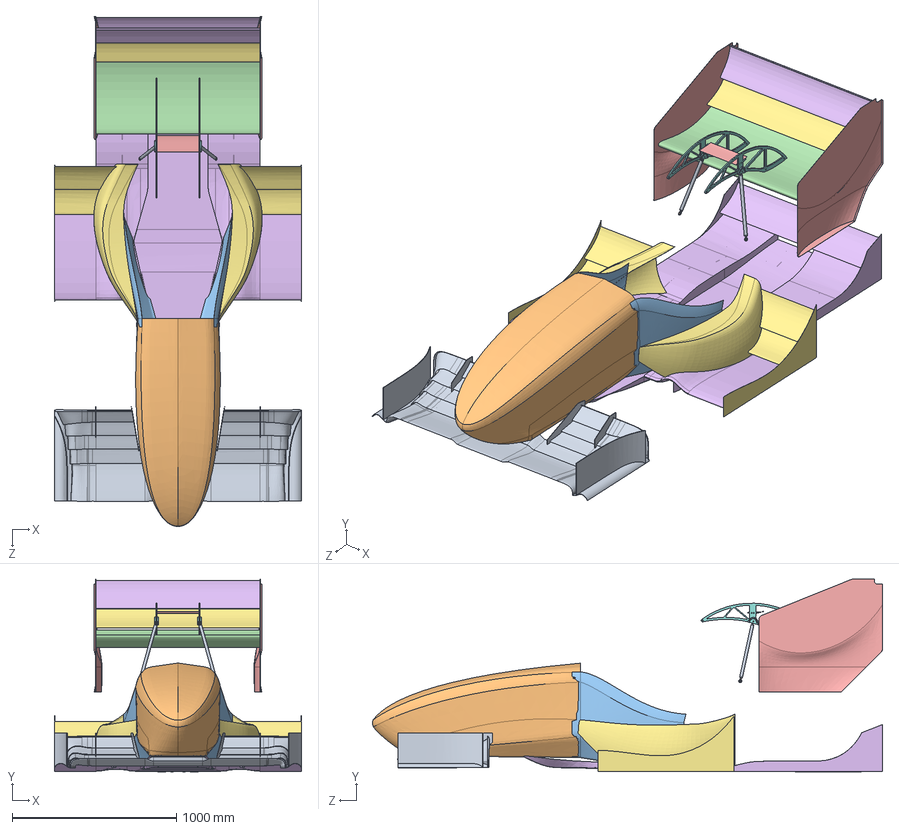
[picture p24: CAD file, 2016-12-03]
4 F2016 Aerodynamics/F16_AE_Assembly.SLDASM
1502.5 x 1171.3 x 3101.7 mm
F16_AE_FrontWing
F16_AE_Nose
F16_AE_CloseOuts
F16_AE_RearWing_MainPlane
F16_AE_RearWing_Endplates
F16_AE_RearWing_FlapWithGurney
F16_AE_RearWing_Flap
F16_AE_RearWing_SwanNecks
F16_AE_RearWing_SwanNeckRods
RAM-4T Case x 4
RAM-4T Rase x 4
RAM-4T Ball x 4
F16_AE_RearWing_SwanNeckFlap
F16_AE_Undertray
F16_AE_SidePodsAssembly
