vishakhkumar/HyTechAero/4 F2016 Aerodynamics/Final RW/F16_AE_RearWing_MainPlane.SLDPRT

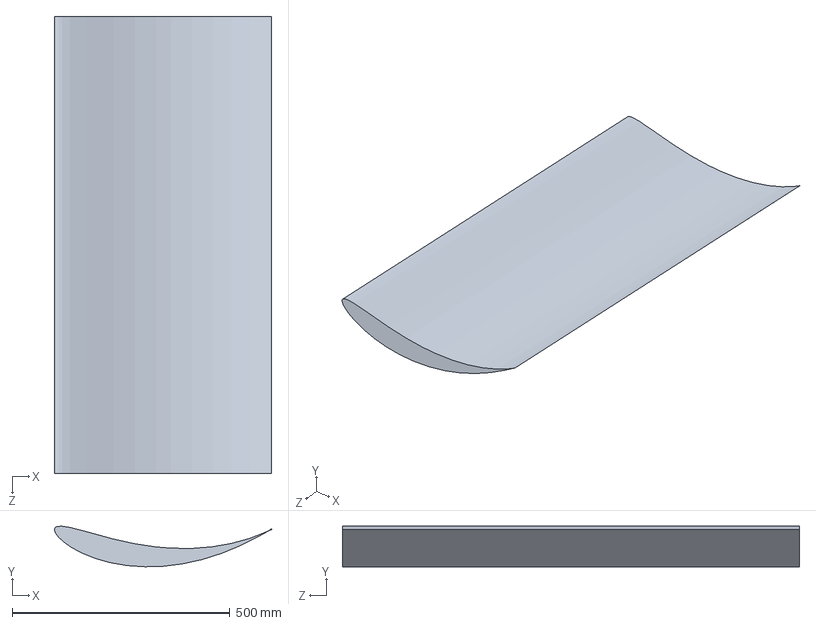
[picture p25: CAD file, 2016-12-03]
4 F2016 Aerodynamics/Final RW/F16_AE_RearWing_MainPlane.SLDPRT
498.5 x 93.3 x 1050.0 mm
