vishakhkumar/HyTechAero/4 F2016 Aerodynamics/Final RW/RAM-4T.SLDASM

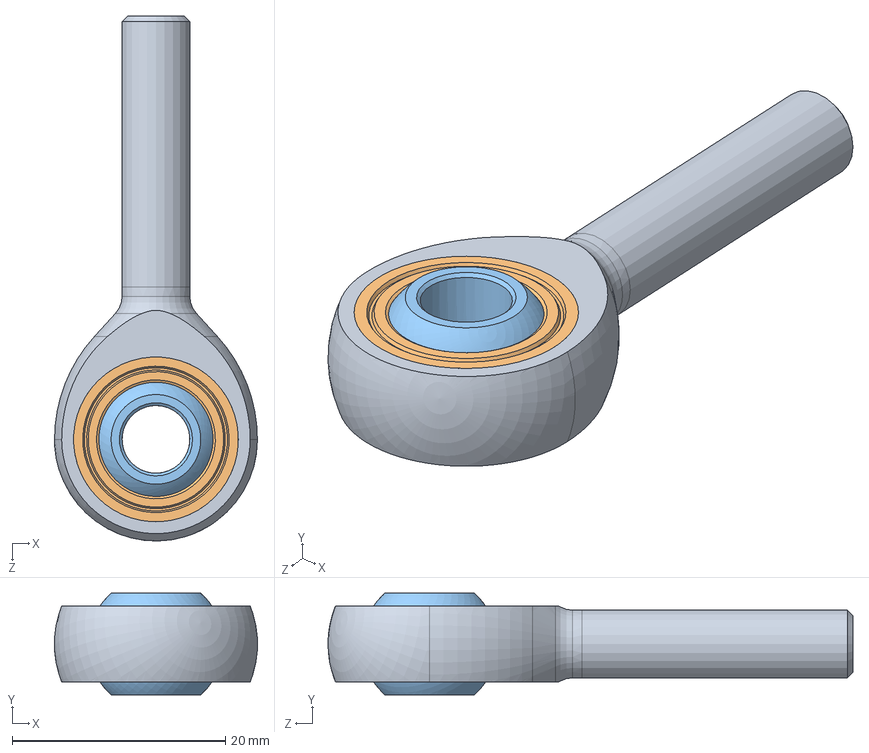
[picture p26: CAD file, 2016-12-03]
4 F2016 Aerodynamics/Final RW/RAM-4T.SLDASM
19.0 x 9.53 x 49.2 mm
RAM-4T Case
RAM-4T Rase
RAM-4T Ball
