vishakhkumar/HyTechAero/4 F2016 Aerodynamics/Final RW/F16_AE_RearWingAssembly.SLDASM

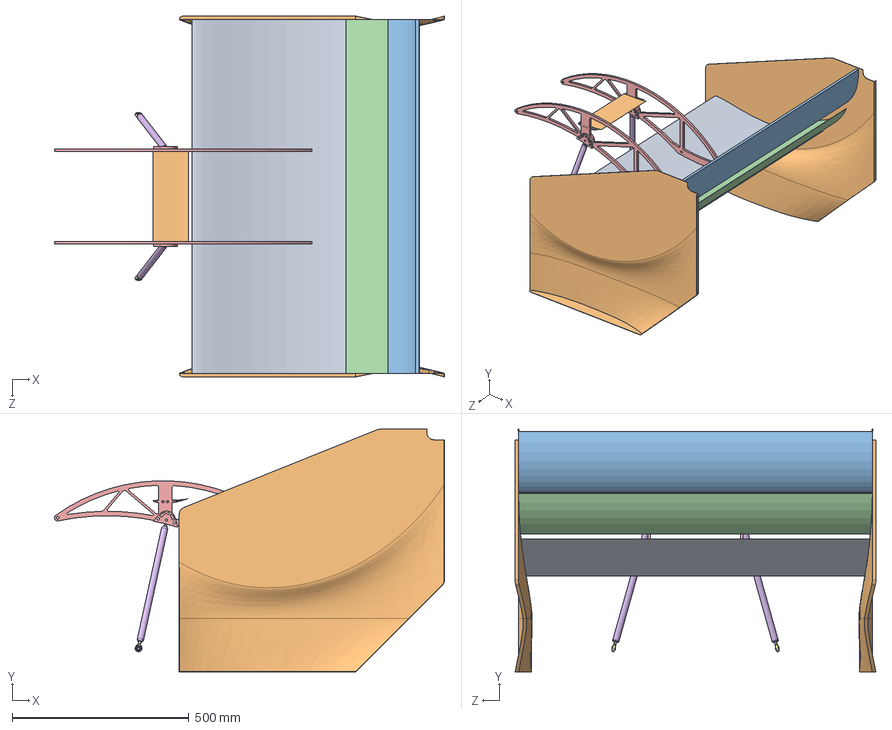
[picture p27: CAD file, 2016-12-03]
4 F2016 Aerodynamics/Final RW/F16_AE_RearWingAssembly.SLDASM
1102.7 x 686.0 x 1020.0 mm
F16_AE_RearWing_MainPlane
F16_AE_RearWing_Endplates
F16_AE_RearWing_FlapWithGurney
F16_AE_RearWing_Flap
F16_AE_RearWing_SwanNecks
F16_AE_RearWing_SwanNeckRods
RAM-4T Case x 4
RAM-4T Rase x 4
RAM-4T Ball x 4
F16_AE_RearWing_SwanNeckFlap
