vishakhkumar/HyTechAero/4 F2016 Aerodynamics/Final RW/F16_AE_RearWing_SwanNeckRodsAssembly.SLDASM

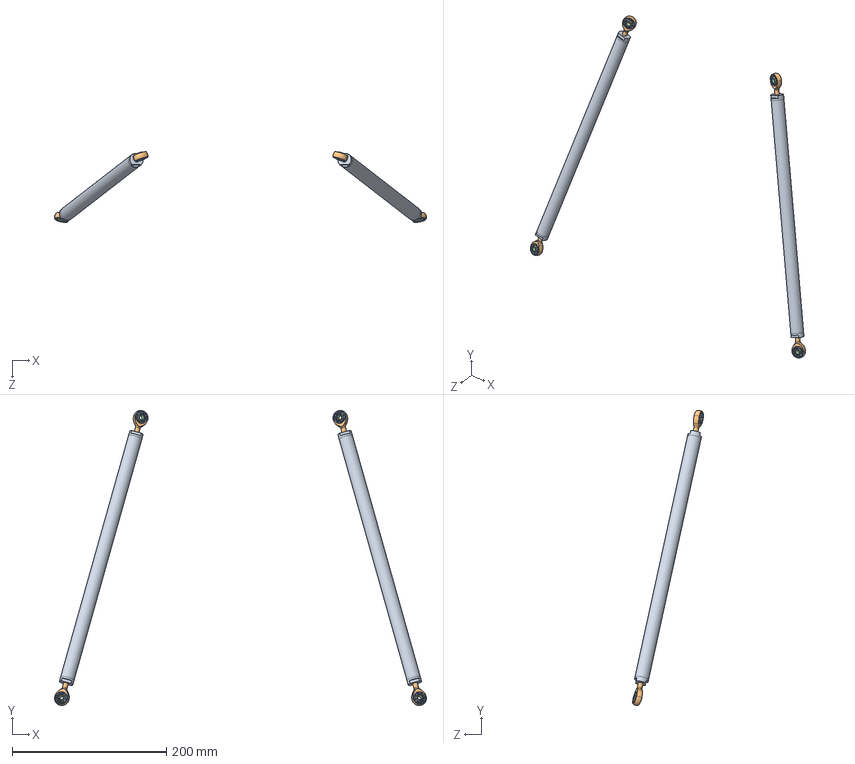
[picture p28: CAD file, 2016-12-03]
4 F2016 Aerodynamics/Final RW/F16_AE_RearWing_SwanNeckRodsAssembly.SLDASM
481.8 x 382.2 x 91.8 mm
F16_AE_RearWing_SwanNeckRods
RAM-4T Case x 4
RAM-4T Rase x 4
RAM-4T Ball x 4
