vishakhkumar/HyTechAero/1 1 Rear Aerodynamic Devices/RearWing/RearB.SLDPRT

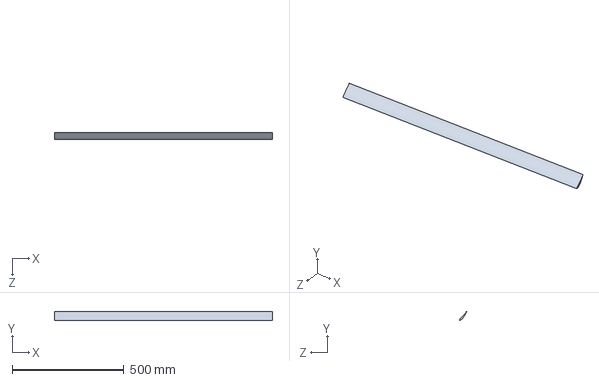
[picture p29: CAD file, 2017-02-21]
1 1 Rear Aerodynamic Devices/RearWing/RearB.SLDPRT
977.0 x 39.8 x 33.0 mm
