vishakhkumar/HyTechAero/1 1 Rear Aerodynamic Devices/RearWing/TemplateWing/RearWing.SLDPRT

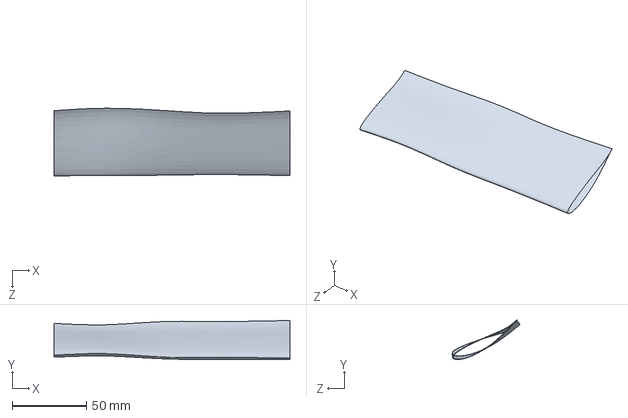
[picture p30: CAD file, 2017-01-21]
1 1 Rear Aerodynamic Devices/RearWing/TemplateWing/RearWing.SLDPRT
159.0 x 26.3 x 45.5 mm
