vishakhkumar/HyTechAero/2 2 Close Out/Close Outs2.SLDPRT

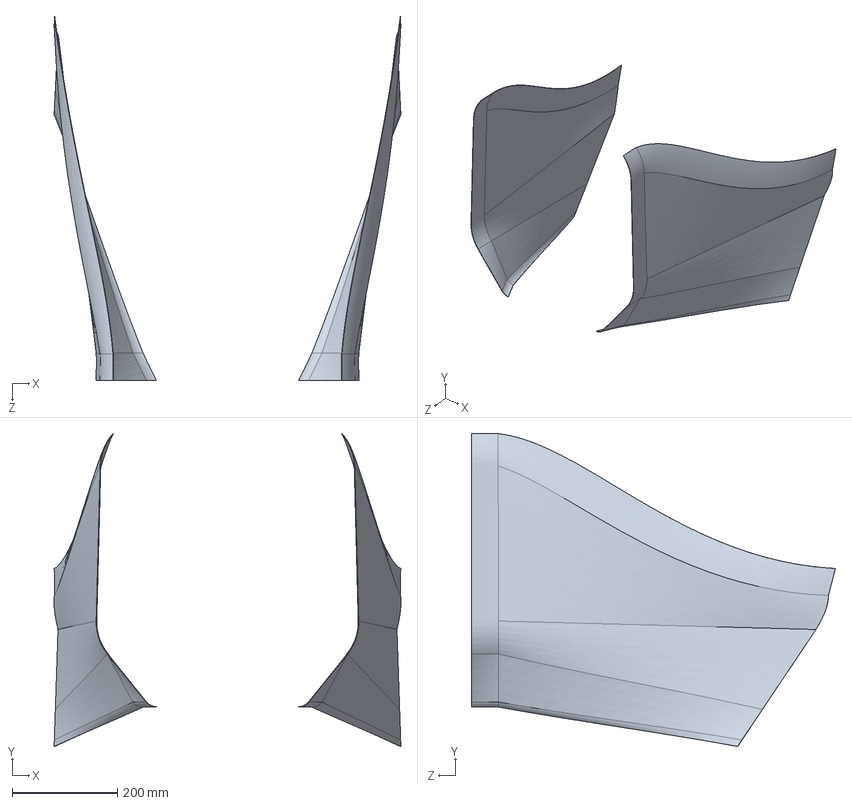
[picture p32: CAD file, 2017-02-21]
2 2 Close Out/Close Outs2.SLDPRT
660.7 x 596.1 x 693.2 mm
