vishakhkumar/HyTechAero/4 F2016 Aerodynamics/F16_AE_CloseOuts.SLDPRT

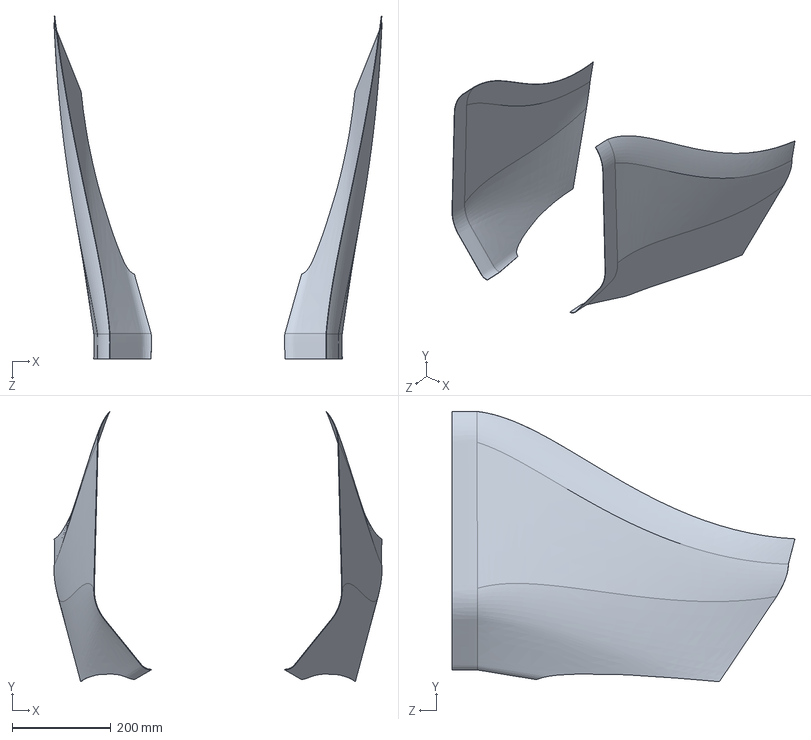
[picture p33: CAD file, 2016-12-03]
4 F2016 Aerodynamics/F16_AE_CloseOuts.SLDPRT
662.6 x 546.4 x 693.0 mm
