vishakhkumar/HyTechAero/4 F2016 Aerodynamics/Final RW/F16_AE_RearWing_FlapWithGurney.SLDPRT

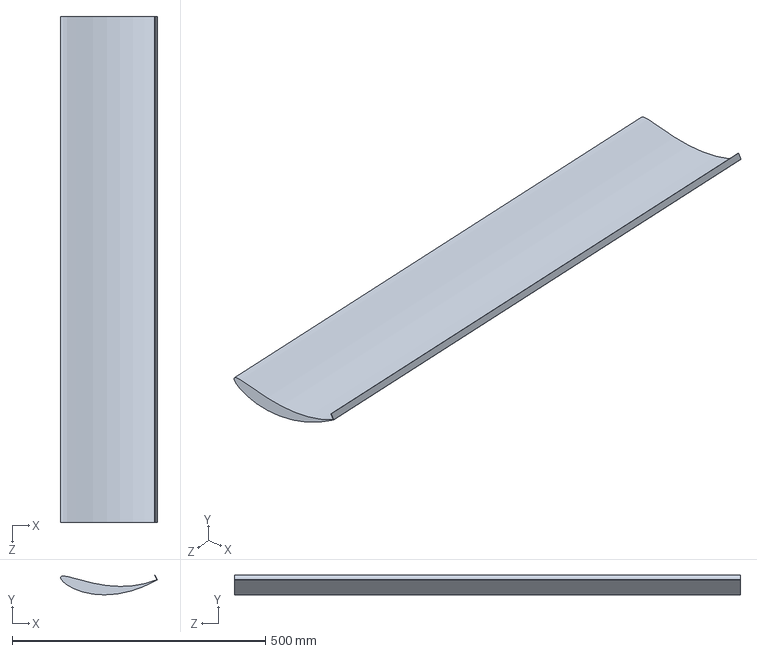
[picture p34: CAD file, 2016-12-03]
4 F2016 Aerodynamics/Final RW/F16_AE_RearWing_FlapWithGurney.SLDPRT
191.2 x 39.2 x 1000.0 mm
