vishakhkumar/HyTechAero/5 Chassis/F.FrameFinal 10-12-16.SLDPRT

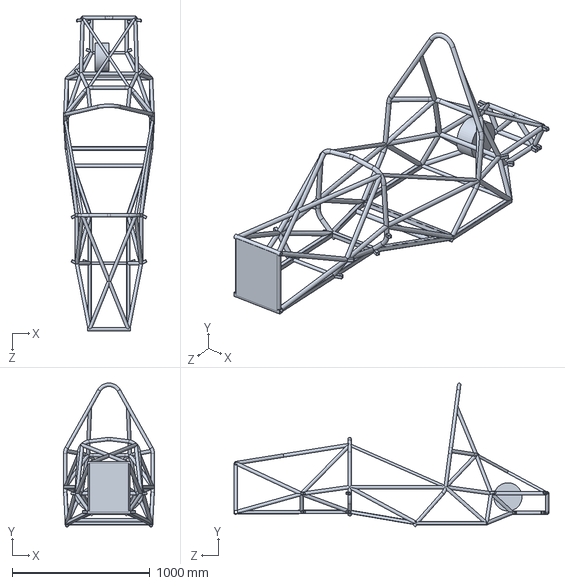
[picture p35: CAD file, 2017-02-19]
5 Chassis/F.FrameFinal 10-12-16.SLDPRT
660.4 x 1043.3 x 2283.3 mm
