vishakhkumar/HyTechAero/1 1 Front Aerodynamic Devices/FrontEndplate/FrontEndplateInner.SLDPRT

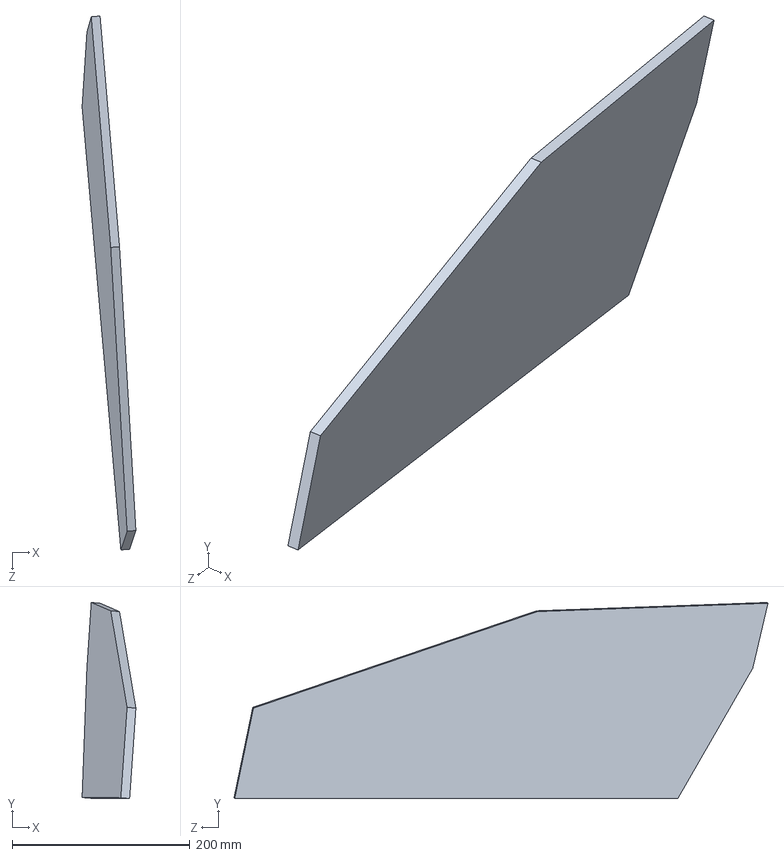
[picture p36: CAD file, 2017-02-21]
1 1 Front Aerodynamic Devices/FrontEndplate/FrontEndplateInner.SLDPRT
60.5 x 220.3 x 600.1 mm
