vishakhkumar/HyTechAero/1 1 Front Aerodynamic Devices/FrontWing/FrontB.SLDPRT

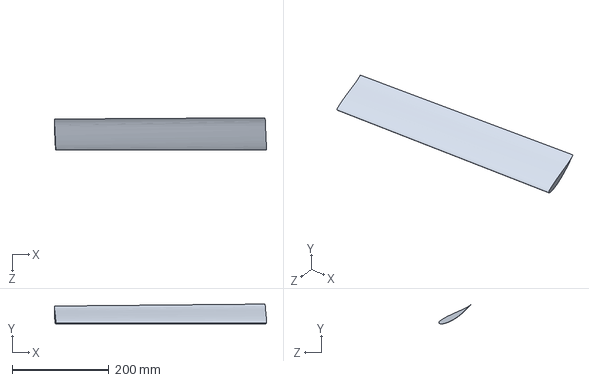
[picture p37: CAD file, 2017-02-21]
1 1 Front Aerodynamic Devices/FrontWing/FrontB.SLDPRT
439.1 x 41.2 x 67.3 mm
