vishakhkumar/HyTechAero/1 1 Rear Aerodynamic Devices/RearEndplate/RearEndplate.SLDPRT

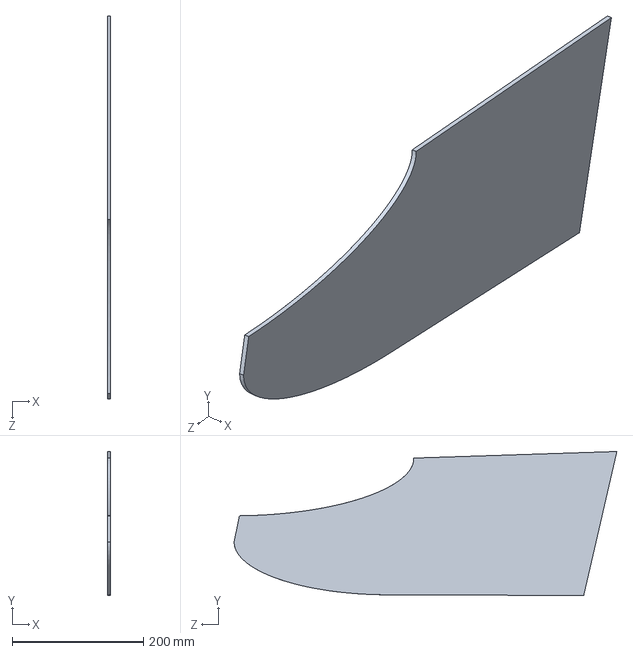
[picture p38: CAD file, 2017-02-21]
1 1 Rear Aerodynamic Devices/RearEndplate/RearEndplate.SLDPRT
5.00 x 219.8 x 584.5 mm
