vishakhkumar/HyTechAero/1 1 Rear Aerodynamic Devices/RearWing/RearC.SLDPRT

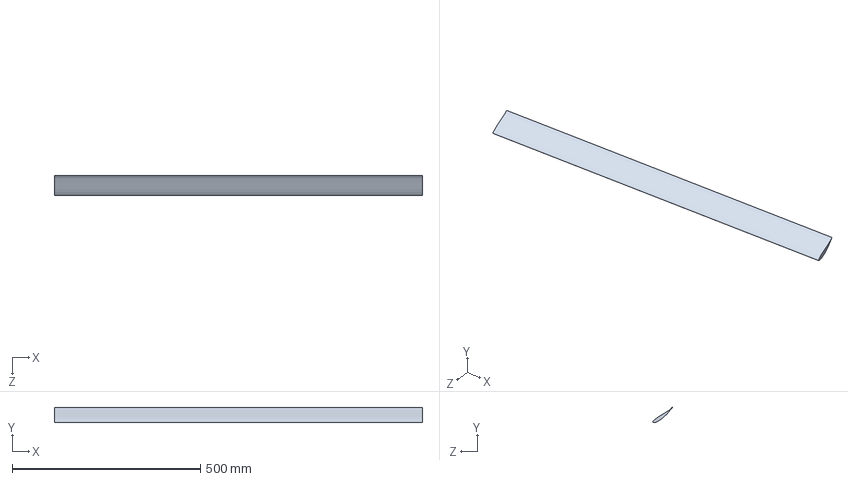
[picture p39: CAD file, 2017-02-21]
1 1 Rear Aerodynamic Devices/RearWing/RearC.SLDPRT
977.0 x 40.6 x 52.0 mm
