vishakhkumar/HyTechAero/2 2 Close Out/closeoutmold.SLDPRT

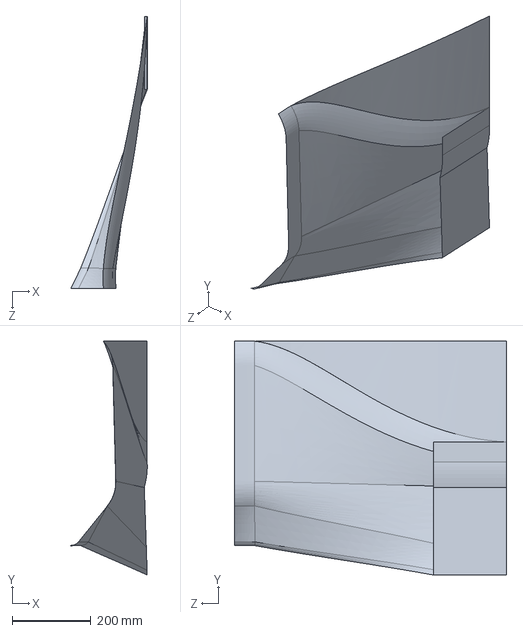
[picture p40: CAD file, 2017-02-21]
2 2 Close Out/closeoutmold.SLDPRT
195.2 x 595.9 x 693.0 mm
