vishakhkumar/HyTechAero/4 F2016 Aerodynamics/F16_AE_Undertray.SLDPRT

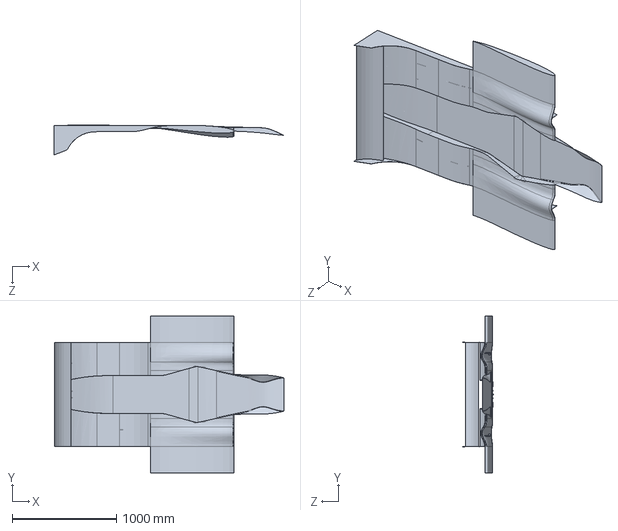
[picture p41: CAD file, 2016-12-03]
4 F2016 Aerodynamics/F16_AE_Undertray.SLDPRT
2201.8 x 1500.0 x 287.3 mm
