vishakhkumar/HyTechAero/1 1 Front Aerodynamic Devices/FrontEndplate/FrontEndplate.SLDPRT

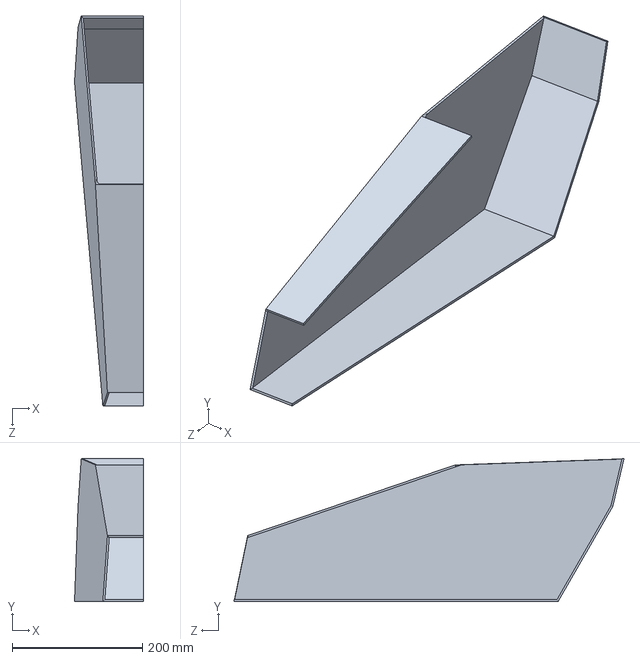
[picture p42: CAD file, 2017-02-21]
1 1 Front Aerodynamic Devices/FrontEndplate/FrontEndplate.SLDPRT
106.1 x 220.2 x 599.3 mm
