vishakhkumar/HyTechAero/1 1 Front Aerodynamic Devices/FrontWing/FrontA.SLDPRT

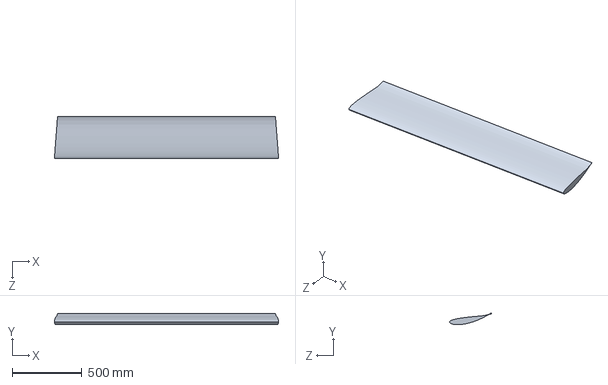
[picture p43: CAD file, 2017-02-21]
1 1 Front Aerodynamic Devices/FrontWing/FrontA.SLDPRT
1600.9 x 81.8 x 299.6 mm
