vishakhkumar/HyTechAero/2 1 Nosecone/Rest.sldprt

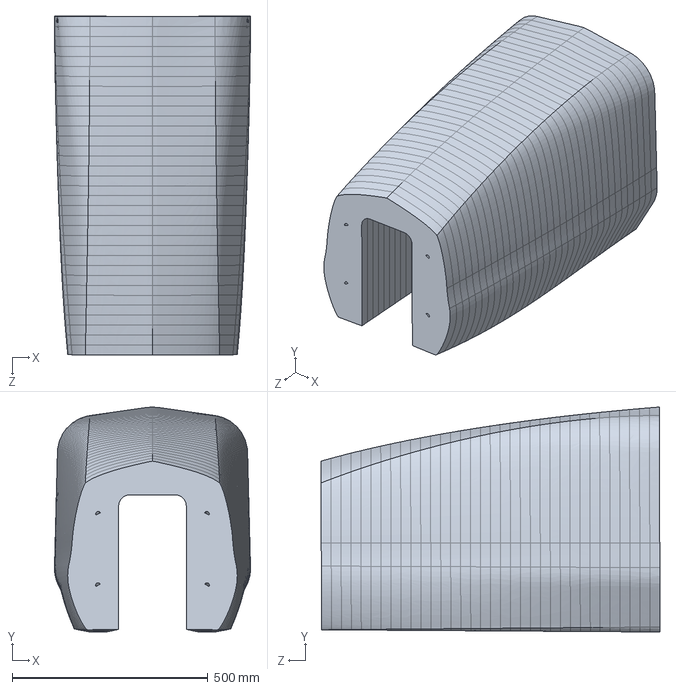
[picture p44: CAD file, 2017-02-21]
2 1 Nosecone/Rest.sldprt
500.2 x 574.0 x 864.7 mm
