vishakhkumar/HyTechAero/2 3 Undertray/UndertrayMold.SLDPRT

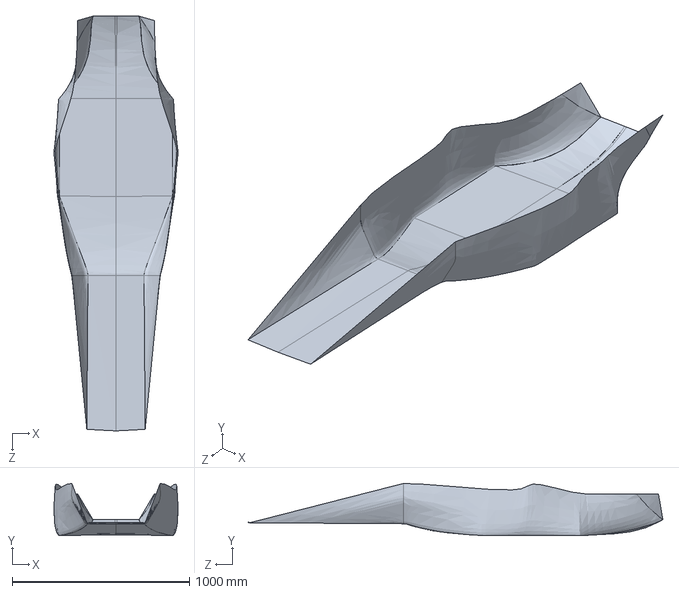
[picture p45: CAD file, 2017-02-21]
2 3 Undertray/UndertrayMold.SLDPRT
699.2 x 293.3 x 2338.8 mm
