vishakhkumar/HyTechAero/4 F2016 Aerodynamics/F16_AE_FrontWing.SLDPRT

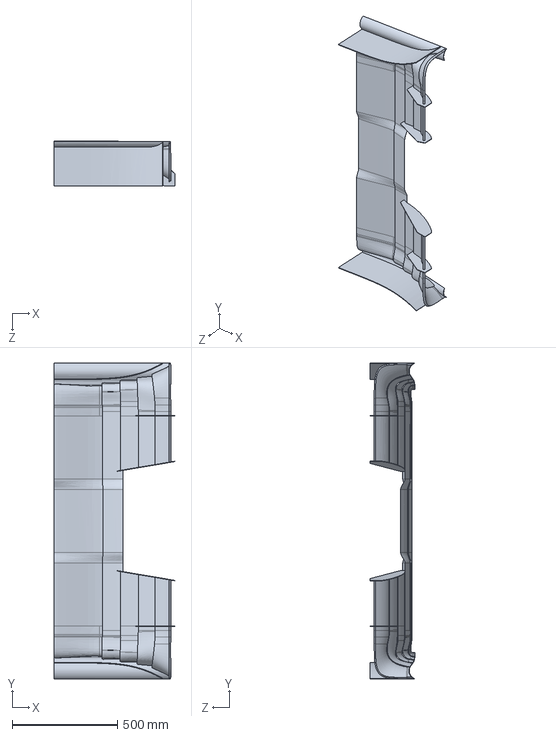
[picture p46: CAD file, 2016-12-03]
4 F2016 Aerodynamics/F16_AE_FrontWing.SLDPRT
575.3 x 1502.5 x 211.7 mm
