vishakhkumar/HyTechAero/4 F2016 Aerodynamics/Final RW/RAM-4T Rase.SLDPRT

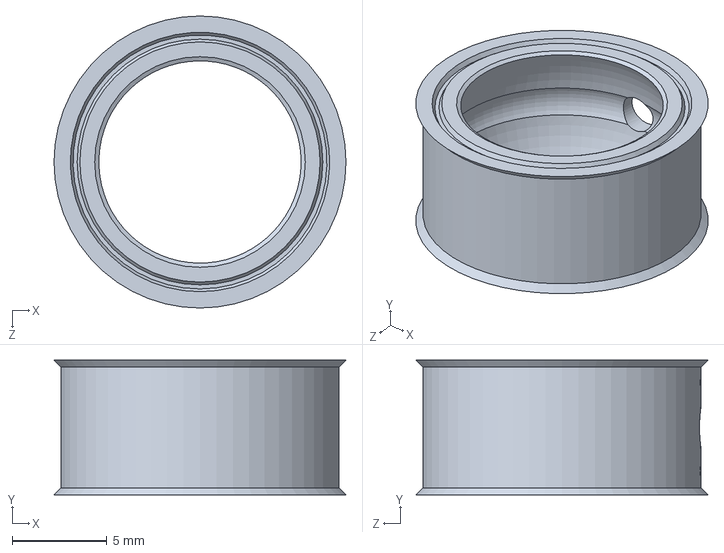
[picture p47: CAD file, 2016-12-03]
4 F2016 Aerodynamics/Final RW/RAM-4T Rase.SLDPRT
15.4 x 7.14 x 15.4 mm
