vishakhkumar/HyTechAero/1 1 Front Aerodynamic Devices/FrontWing/FrontC.SLDPRT

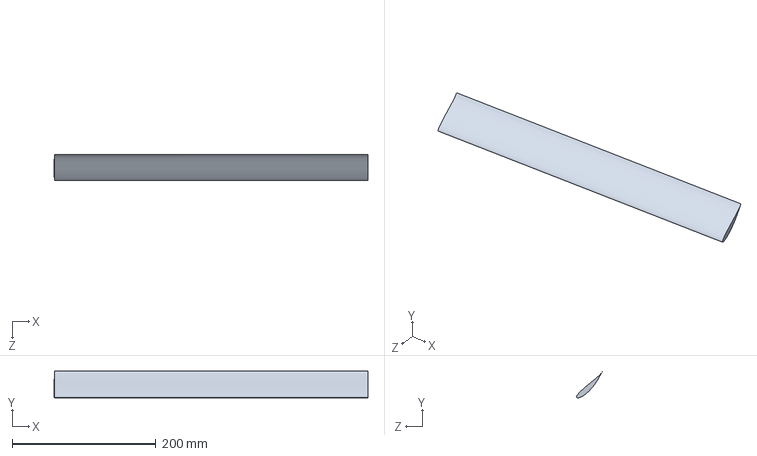
[picture p48: CAD file, 2017-02-21]
1 1 Front Aerodynamic Devices/FrontWing/FrontC.SLDPRT
437.4 x 37.5 x 36.7 mm
