vishakhkumar/HyTechAero/1 1 Rear Aerodynamic Devices/RearEndplate/GenericEndplate.SLDPRT

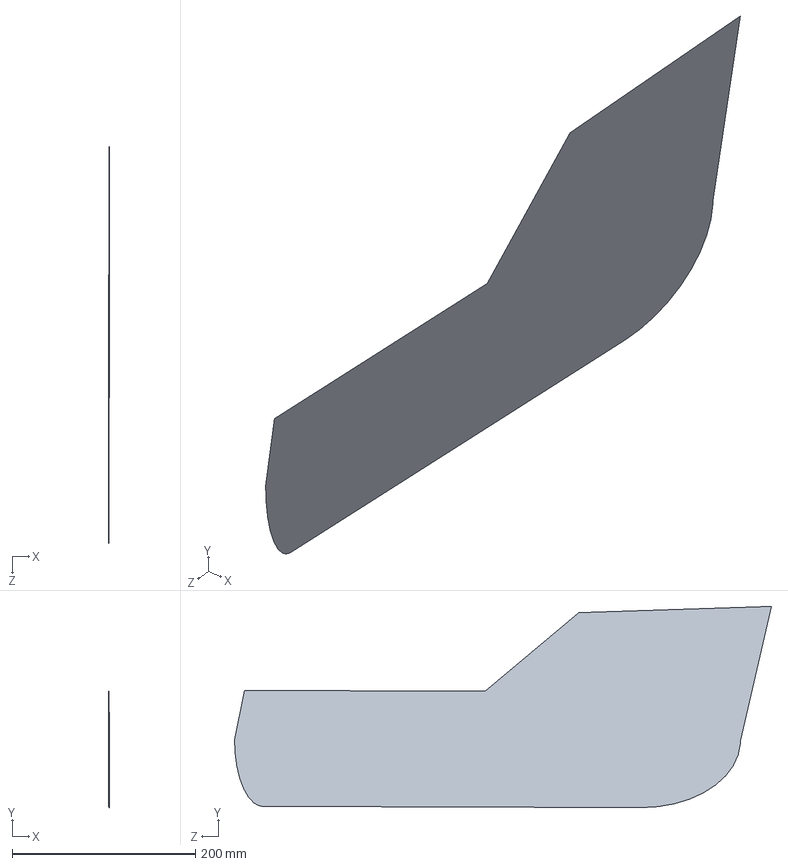
[picture p49: CAD file, 2017-02-05]
1 1 Rear Aerodynamic Devices/RearEndplate/GenericEndplate.SLDPRT
4.7e-12 x 219.5 x 585.9 mm
