vishakhkumar/HyTechAero/1 1 Rear Aerodynamic Devices/RearWing/RearA.SLDPRT

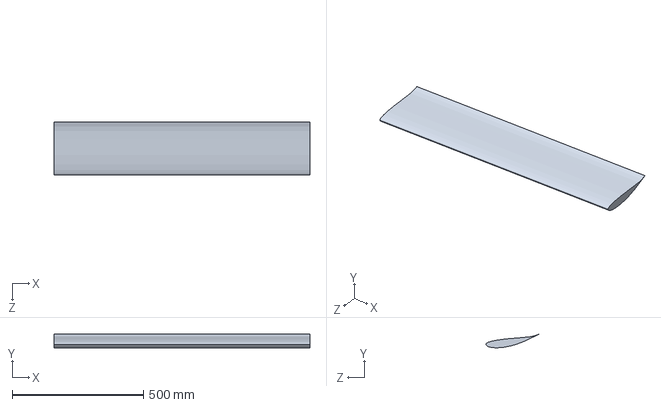
[picture p50: CAD file, 2017-02-21]
1 1 Rear Aerodynamic Devices/RearWing/RearA.SLDPRT
977.0 x 52.5 x 202.1 mm
