vishakhkumar/HyTechAero/2 1 Nosecone/Tip.sldprt

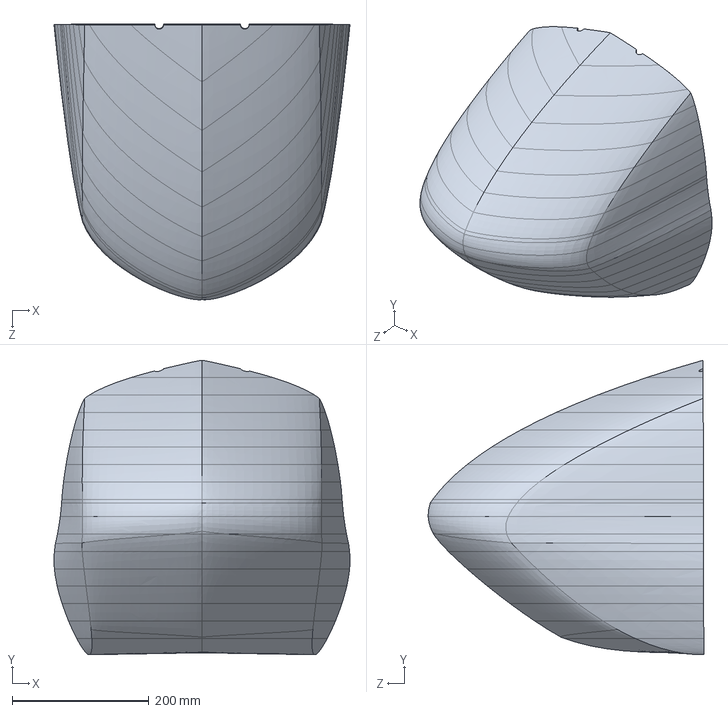
[picture p51: CAD file, 2017-02-21]
2 1 Nosecone/Tip.sldprt
432.5 x 430.3 x 402.8 mm
