vishakhkumar/HyTechAero/4 F2016 Aerodynamics/Final RW/F16_AE_RearWing_SwanNeckFlap.SLDPRT

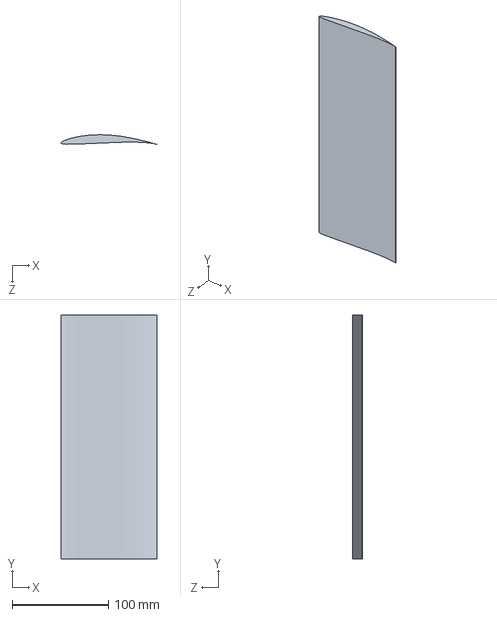
[picture p52: CAD file, 2016-12-03]
4 F2016 Aerodynamics/Final RW/F16_AE_RearWing_SwanNeckFlap.SLDPRT
99.7 x 254.0 x 10.1 mm
