vishakhkumar/HyTechAero/2 1 Nosecone/NewNoseConeMold.SLDPRT

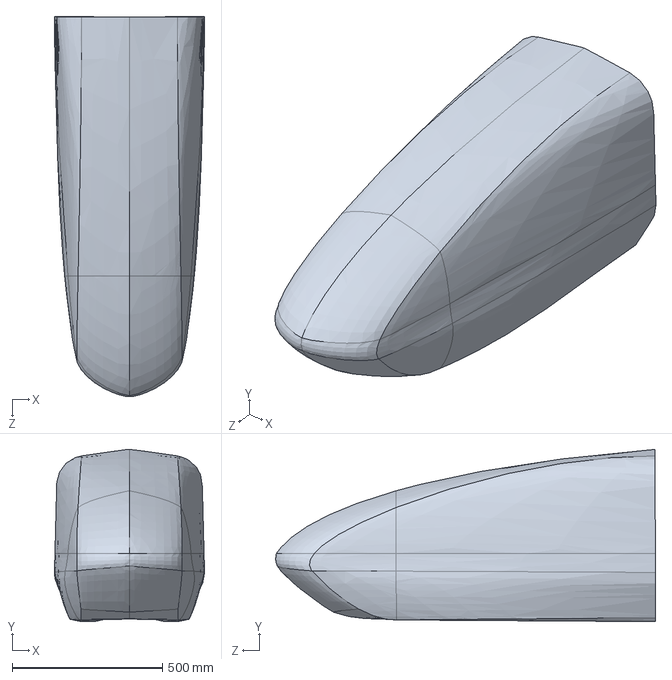
[picture p53: CAD file, 2017-02-21]
2 1 Nosecone/NewNoseConeMold.SLDPRT
500.2 x 574.0 x 1266.2 mm
