vishakhkumar/HyTechAero/2 2 Close Out/box.SLDPRT

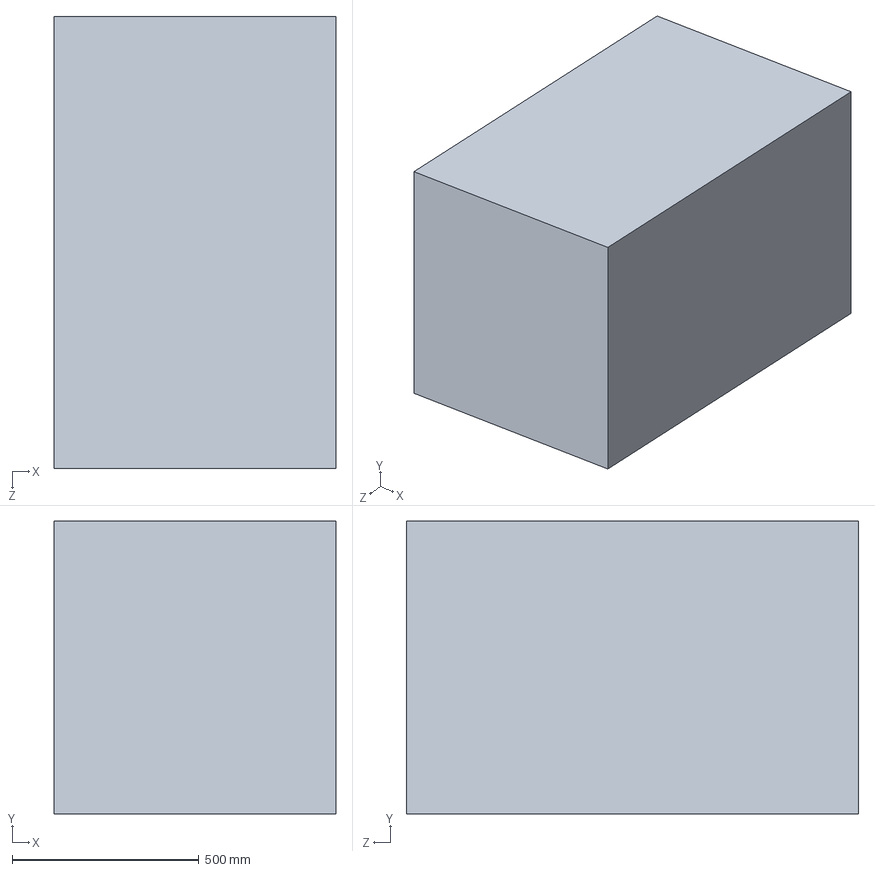
[picture p54: CAD file, 2017-02-21]
2 2 Close Out/box.SLDPRT
753.1 x 783.0 x 1209.0 mm
