vishakhkumar/HyTechAero/4 F2016 Aerodynamics/F16_AE_Nose.SLDPRT

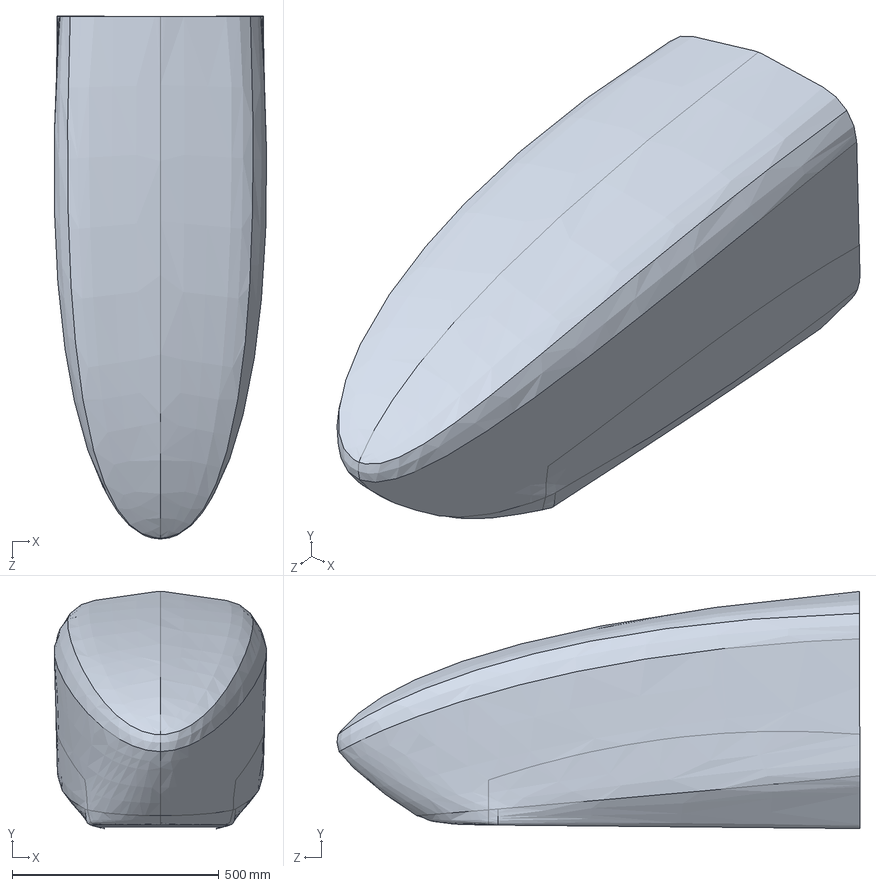
[picture p55: CAD file, 2016-12-03]
4 F2016 Aerodynamics/F16_AE_Nose.SLDPRT
513.7 x 574.0 x 1265.7 mm
