vishakhkumar/HyTechAero/4 F2016 Aerodynamics/Final RW/F16_AE_RearWing_CrossRodInsert.SLDPRT

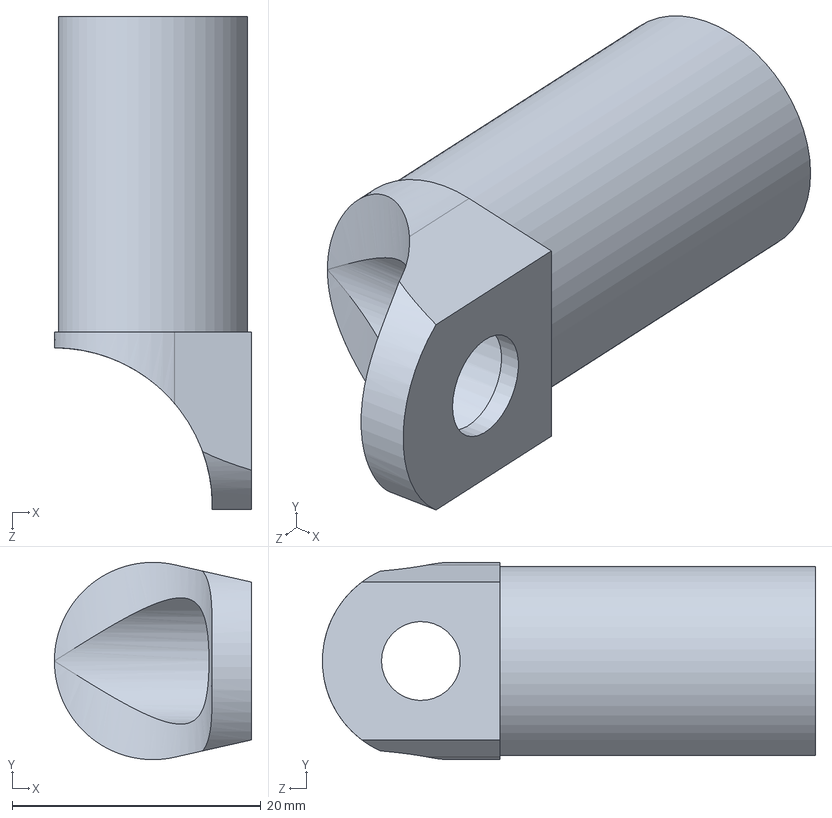
[picture p56: CAD file, 2016-12-03]
4 F2016 Aerodynamics/Final RW/F16_AE_RearWing_CrossRodInsert.SLDPRT
15.9 x 15.9 x 39.7 mm
