vishakhkumar/HyTechAero/4 F2016 Aerodynamics/Final RW/F16_AE_RearWing_SwanNecks.SLDPRT

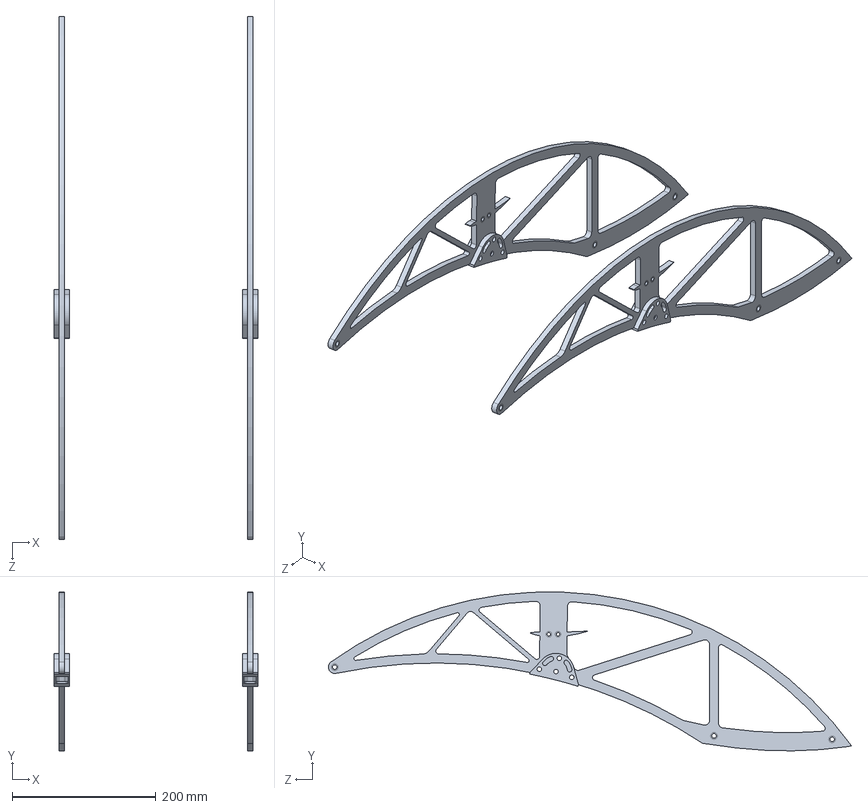
[picture p57: CAD file, 2016-12-03]
4 F2016 Aerodynamics/Final RW/F16_AE_RearWing_SwanNecks.SLDPRT
283.8 x 220.8 x 728.0 mm
