vishakhkumar/HyTechAero/4 F2016 Aerodynamics/Final RW/F16_AE_RearWing_Endplates.sldprt

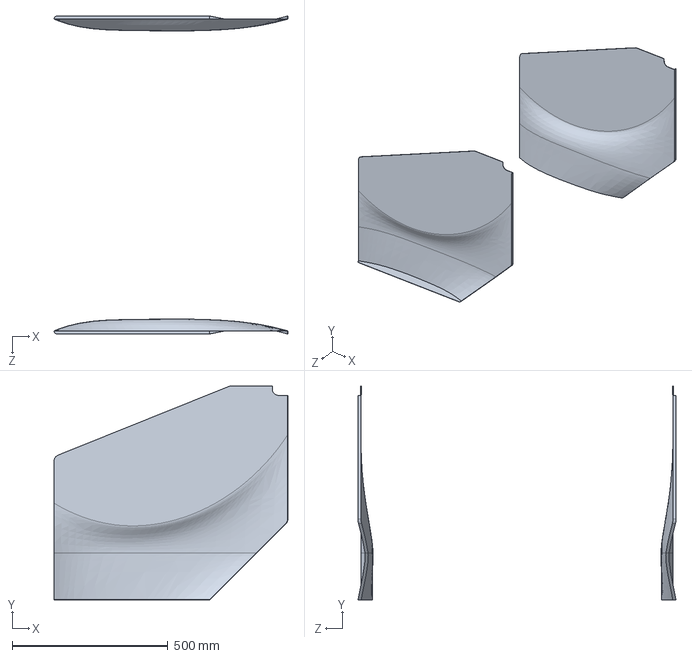
[picture p58: CAD file, 2016-12-03]
4 F2016 Aerodynamics/Final RW/F16_AE_RearWing_Endplates.sldprt
750.0 x 686.0 x 1020.0 mm
