vishakhkumar/HyTechAero/4 F2016 Aerodynamics/Final RW/RAM-4T Case.SLDPRT

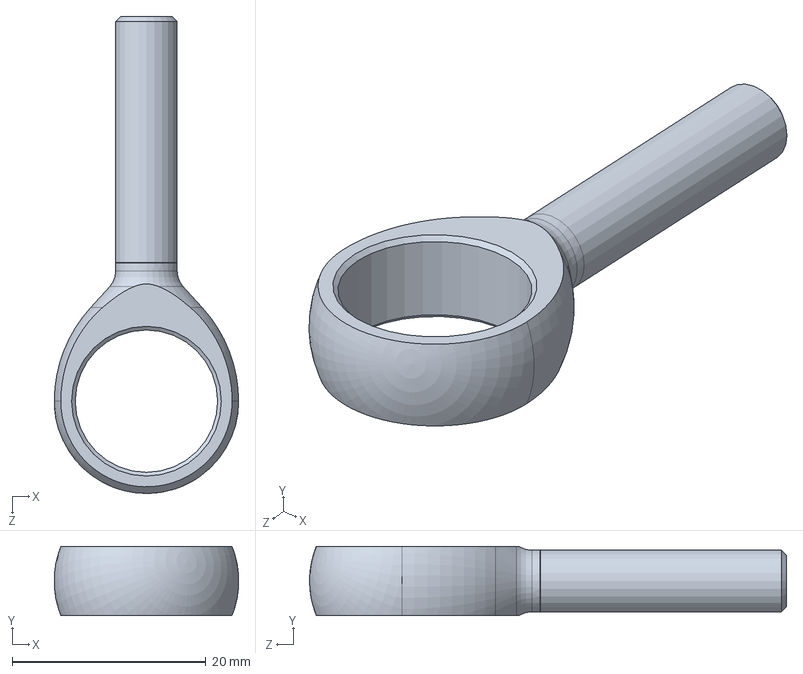
[picture p59: CAD file, 2016-12-03]
4 F2016 Aerodynamics/Final RW/RAM-4T Case.SLDPRT
19.0 x 7.14 x 49.2 mm
