vishakhkumar/HyTechAero/4 F2016 Aerodynamics/Final RW/RAM-4T Ball.SLDPRT

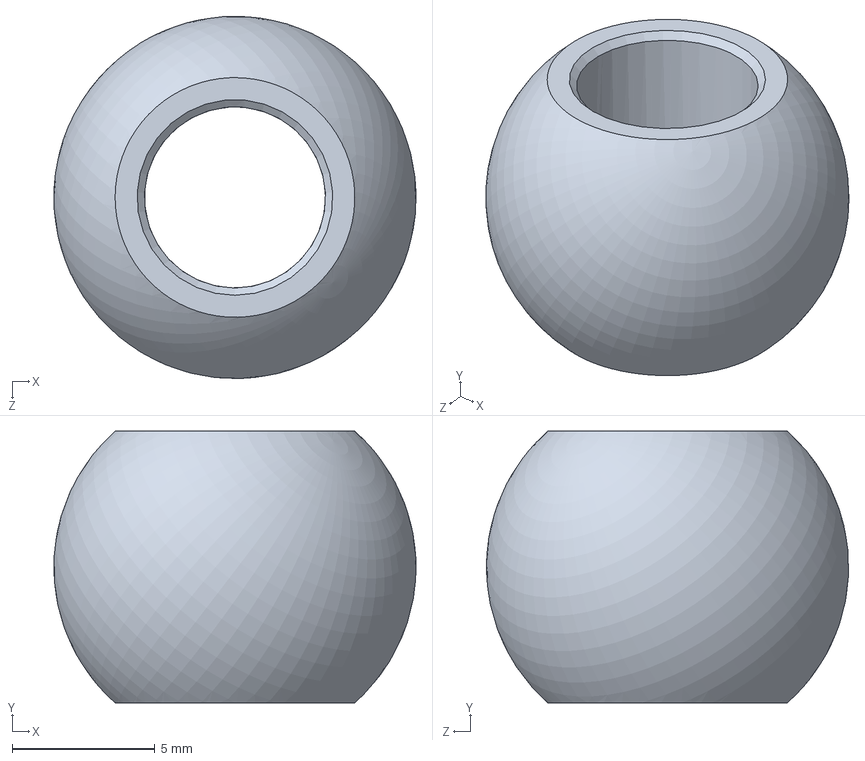
[picture p60: CAD file, 2016-12-03]
4 F2016 Aerodynamics/Final RW/RAM-4T Ball.SLDPRT
12.7 x 9.53 x 12.7 mm
