vishakhkumar/HyTechAero/4 F2016 Aerodynamics/Final RW/F16_AE_RearWing_Flap.SLDPRT

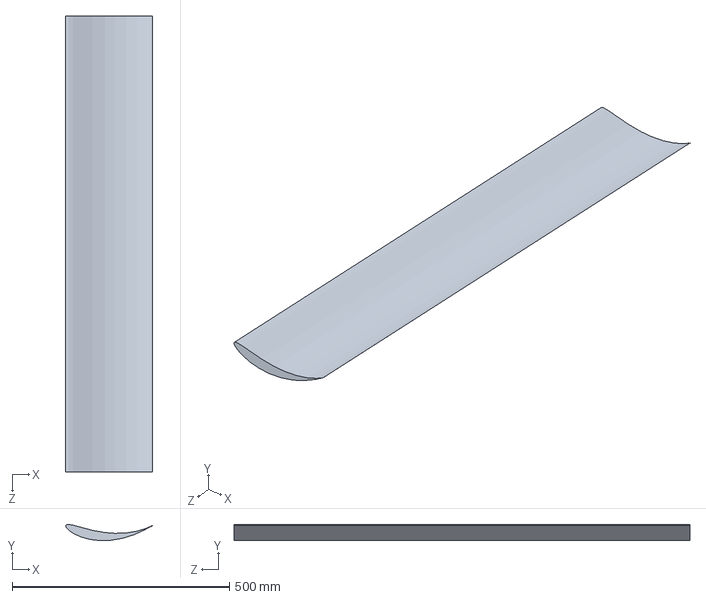
[picture p61: CAD file, 2016-12-03]
4 F2016 Aerodynamics/Final RW/F16_AE_RearWing_Flap.SLDPRT
199.4 x 37.2 x 1050.0 mm
