vishakhkumar/HyTechAero/4 F2016 Aerodynamics/Final RW/F16_AE_RearWing_SwanNeckRods.SLDPRT

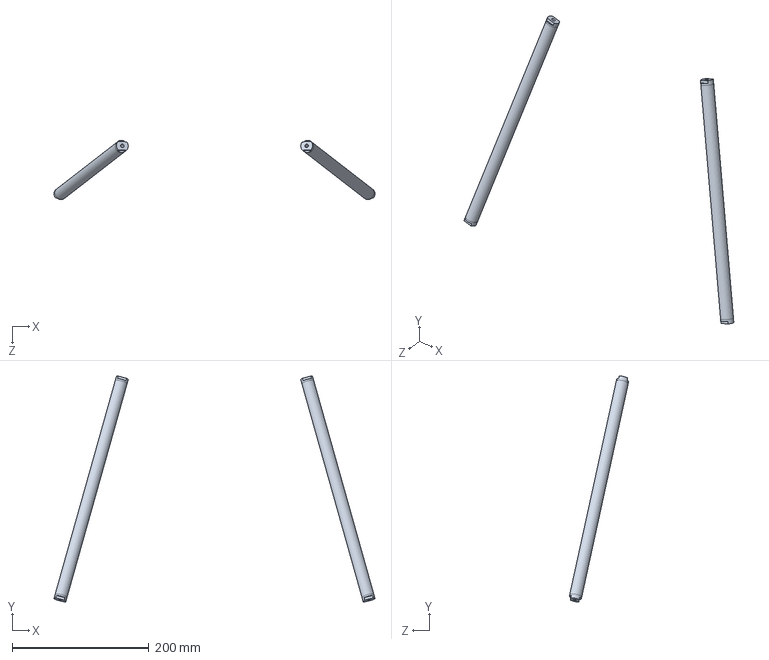
[picture p62: CAD file, 2016-12-03]
4 F2016 Aerodynamics/Final RW/F16_AE_RearWing_SwanNeckRods.SLDPRT
469.2 x 330.3 x 86.8 mm
