vishakhkumar/HyTechAero/(list of files, cad)

Other CAD files:
0 Airfoils/AirfoilData/Benzing Airfoils/Be122-155.SLDPRT
1 1 Front Aerodynamic Devices/FrontEndplate/MirrorFrontEndplate.SLDPRT
1 1 Front Aerodynamic Devices/FrontWing/MirrorB.SLDPRT
1 1 Front Aerodynamic Devices/FrontWing/Mold Files/FrontA/Body19.sldprt
1 1 Rear Aerodynamic Devices/RearWing/Mold Files/RearC/Body38.sldprt
2 1 Nosecone/New Mold Files/Rest/Body20.sldprt
2 1 Nosecone/New Mold Files/Tip/Body10.sldprt
0 Airfoils/AirfoilData/Benzing Airfoils/Be153-175.SLDPRT
1 1 Front Aerodynamic Devices/FrontWing/Mold Files/FrontA/Body23.sldprt
1 1 Rear Aerodynamic Devices/RearWing/Mold Files/RearC/Body2.sldprt
2 1 Nosecone/New Mold Files/Rest/Body21.sldprt
2 1 Nosecone/New Mold Files/Tip/Body5.sldprt
2 3 Undertray/Undertray.SLDPRT
0 Airfoils/AirfoilData/Benzing Airfoils/Be122-125.SLDPRT
1 1 Front Aerodynamic Devices/FrontWing/Mold Files/FrontA/Body61.sldprt
1 1 Front Aerodynamic Devices/FrontWing/Mold Files/FrontB/Body1.sldprt
1 1 Front Aerodynamic Devices/FrontWing/Mold Files/FrontC/Body1.sldprt
1 1 Rear Aerodynamic Devices/RearEndplate/MirrorRearEndplate.SLDPRT
2 1 Nosecone/New Mold Files/Rest/Body27.sldprt
2 1 Nosecone/New Mold Files/Tip/Body9.sldprt
2 2 Close Out/Part1.SLDPRT
0 Airfoils/AirfoilData/Benzing Airfoils/Be122-185.SLDPRT
1 1 Front Aerodynamic Devices/FrontEndplate/MirrorFrontEndplateInner.SLDPRT
1 1 Front Aerodynamic Devices/FrontWing/Mold Files/FrontA/Body6.sldprt
2 1 Nosecone/New Mold Files/Rest/Body5.sldprt
2 1 Nosecone/New Mold Files/Tip/Body16.sldprt
0 Airfoils/AirfoilData/Benzing Airfoils/Be153-055.SLDPRT
1 1 Front Aerodynamic Devices/FrontWing/Mold Files/FrontA/Body53.sldprt
1 1 Rear Aerodynamic Devices/RearWing/MirrorB.SLDPRT
2 1 Nosecone/New Mold Files/Rest/Body24.sldprt
2 1 Nosecone/New Mold Files/Tip/Body6.sldprt
0 Airfoils/AirfoilData/Benzing Airfoils/Be153-105.SLDPRT
1 1 Front Aerodynamic Devices/FrontWing/MirrorC.SLDPRT
1 1 Front Aerodynamic Devices/FrontWing/Mold Files/FrontA/Body10.sldprt
1 1 Rear Aerodynamic Devices/RearWing/MirrorC.SLDPRT
2 1 Nosecone/Body49.sldprt
2 1 Nosecone/New Mold Files/Rest/Body4.sldprt
2 1 Nosecone/New Mold Files/Tip/Body7.sldprt
2 2 Close Out/Close Outs Right.SLDPRT
1 1 Front Aerodynamic Devices/FrontWing/Mold Files/FrontA/Body64.sldprt
2 1 Nosecone/Body10.sldprt
2 1 Nosecone/New Mold Files/Rest/Body30.sldprt
2 1 Nosecone/New Mold Files/Tip/Body11.sldprt
1 1 Front Aerodynamic Devices/FrontWing/Mold Files/FrontA/Body34.sldprt
1 1 Front Aerodynamic Devices/FrontWing/Mold Files/FrontB/Body2.sldprt
2 1 Nosecone/Body24.sldprt
2 1 Nosecone/New Mold Files/Rest/Body15.sldprt
2 1 Nosecone/New Mold Files/Tip/Body4.sldprt
4 F2016 Aerodynamics/foil1.SLDPRT
1 1 Front Aerodynamic Devices/FrontWing/Mold Files/FrontA/Body55.sldprt
1 1 Rear Aerodynamic Devices/RearWing/Mold Files/RearB/Body39.sldprt
2 1 Nosecone/Body19.sldprt
2 1 Nosecone/New Mold Files/Rest/Body28.sldprt
2 1 Nosecone/New Mold Files/Tip/Body13.sldprt
1 1 Front Aerodynamic Devices/FrontWing/Mold Files/FrontA/Body25.sldprt
1 1 Front Aerodynamic Devices/FrontWing/Mold Files/FrontC/Body2.sldprt
1 1 Rear Aerodynamic Devices/RearWing/Mold Files/RearB/Body38.sldprt
2 1 Nosecone/Body51.sldprt
2 1 Nosecone/New Mold Files/Rest/Body31.sldprt
2 1 Nosecone/New Mold Files/Tip/Body18.sldprt
1 1 Front Aerodynamic Devices/FrontWing/Mold Files/FrontA/Body41.sldprt
2 1 Nosecone/Body31.sldprt
2 1 Nosecone/New Mold Files/Rest/Body17.sldprt
2 1 Nosecone/New Mold Files/Tip/Body14.sldprt
1 1 Front Aerodynamic Devices/FrontWing/Mold Files/FrontA/Body43.sldprt
2 1 Nosecone/Body32.sldprt
2 1 Nosecone/New Mold Files/Rest/Body6.sldprt
2 1 Nosecone/New Mold Files/Tip/Body8.sldprt
1 1 Front Aerodynamic Devices/FrontWing/Mold Files/FrontA/Body16.sldprt
2 1 Nosecone/Body12.sldprt
2 1 Nosecone/New Mold Files/Rest/Body18.sldprt
2 1 Nosecone/New Mold Files/Tip/Body15.sldprt
1 1 Front Aerodynamic Devices/FrontWing/Mold Files/FrontA/Body1.sldprt
1 1 Rear Aerodynamic Devices/RearWing/Mold Files/RearA/Body39.sldprt
2 1 Nosecone/Body13.sldprt
2 1 Nosecone/New Mold Files/Rest/Body13.sldprt
2 1 Nosecone/New Mold Files/Tip/Body17.sldprt
1 1 Front Aerodynamic Devices/FrontWing/Mold Files/FrontA/Body44.sldprt
2 1 Nosecone/Body52.sldprt
2 1 Nosecone/New Mold Files/Rest/Body11.sldprt
2 1 Nosecone/New Mold Files/Tip/Body3.sldprt
1 1 Front Aerodynamic Devices/FrontWing/Mold Files/FrontA/Body52.sldprt
2 1 Nosecone/Body11.sldprt
2 1 Nosecone/New Mold Files/Rest/Body35.sldprt
2 1 Nosecone/New Mold Files/Tip/Body19.sldprt
1 1 Front Aerodynamic Devices/FrontWing/Mold Files/FrontA/Body50.sldprt
1 1 Rear Aerodynamic Devices/RearWing/Mold Files/RearC/Body37.sldprt
2 1 Nosecone/Body46.sldprt
2 1 Nosecone/New Mold Files/Rest/Body12.sldprt
2 1 Nosecone/New Mold Files/Tip/Body12.sldprt
1 1 Front Aerodynamic Devices/FrontWing/Mold Files/FrontA/Body28.sldprt
2 1 Nosecone/Body27.sldprt
2 1 Nosecone/New Mold Files/Rest/Body23.sldprt
1 1 Front Aerodynamic Devices/FrontWing/Mold Files/FrontA/Body36.sldprt
1 1 Rear Aerodynamic Devices/RearWing/Mold Files/RearC/Body39.sldprt
2 1 Nosecone/Body18.sldprt
2 1 Nosecone/New Mold Files/Rest/Body34.sldprt
1 1 Front Aerodynamic Devices/FrontWing/Mold Files/FrontA/Body11.sldprt
1 1 Front Aerodynamic Devices/FrontWing/Mold Files/FrontA/Body12.sldprt
1 1 Front Aerodynamic Devices/FrontWing/Mold Files/FrontA/Body13.sldprt
1 1 Front Aerodynamic Devices/FrontWing/Mold Files/FrontA/Body14.sldprt
1 1 Front Aerodynamic Devices/FrontWing/Mold Files/FrontA/Body15.sldprt
1 1 Front Aerodynamic Devices/FrontWing/Mold Files/FrontA/Body17.sldprt
1 1 Front Aerodynamic Devices/FrontWing/Mold Files/FrontA/Body18.sldprt
1 1 Front Aerodynamic Devices/FrontWing/Mold Files/FrontA/Body2.sldprt
1 1 Front Aerodynamic Devices/FrontWing/Mold Files/FrontA/Body20.sldprt
1 1 Front Aerodynamic Devices/FrontWing/Mold Files/FrontA/Body21.sldprt
1 1 Front Aerodynamic Devices/FrontWing/Mold Files/FrontA/Body22.sldprt
1 1 Front Aerodynamic Devices/FrontWing/Mold Files/FrontA/Body24.sldprt
1 1 Front Aerodynamic Devices/FrontWing/Mold Files/FrontA/Body26.sldprt
1 1 Front Aerodynamic Devices/FrontWing/Mold Files/FrontA/Body27.sldprt
1 1 Front Aerodynamic Devices/FrontWing/Mold Files/FrontA/Body29.sldprt
1 1 Front Aerodynamic Devices/FrontWing/Mold Files/FrontA/Body3.sldprt
1 1 Front Aerodynamic Devices/FrontWing/Mold Files/FrontA/Body30.sldprt
1 1 Front Aerodynamic Devices/FrontWing/Mold Files/FrontA/Body31.sldprt
1 1 Front Aerodynamic Devices/FrontWing/Mold Files/FrontA/Body32.sldprt
1 1 Front Aerodynamic Devices/FrontWing/Mold Files/FrontA/Body33.sldprt
1 1 Front Aerodynamic Devices/FrontWing/Mold Files/FrontA/Body35.sldprt
1 1 Front Aerodynamic Devices/FrontWing/Mold Files/FrontA/Body37.sldprt
1 1 Front Aerodynamic Devices/FrontWing/Mold Files/FrontA/Body38.sldprt
1 1 Front Aerodynamic Devices/FrontWing/Mold Files/FrontA/Body39.sldprt
1 1 Front Aerodynamic Devices/FrontWing/Mold Files/FrontA/Body4.sldprt
1 1 Front Aerodynamic Devices/FrontWing/Mold Files/FrontA/Body40.sldprt
1 1 Front Aerodynamic Devices/FrontWing/Mold Files/FrontA/Body42.sldprt
1 1 Front Aerodynamic Devices/FrontWing/Mold Files/FrontA/Body45.sldprt
1 1 Front Aerodynamic Devices/FrontWing/Mold Files/FrontA/Body46.sldprt
1 1 Front Aerodynamic Devices/FrontWing/Mold Files/FrontA/Body47.sldprt
1 1 Front Aerodynamic Devices/FrontWing/Mold Files/FrontA/Body48.sldprt
1 1 Front Aerodynamic Devices/FrontWing/Mold Files/FrontA/Body49.sldprt
1 1 Front Aerodynamic Devices/FrontWing/Mold Files/FrontA/Body5.sldprt
1 1 Front Aerodynamic Devices/FrontWing/Mold Files/FrontA/Body51.sldprt
1 1 Front Aerodynamic Devices/FrontWing/Mold Files/FrontA/Body54.sldprt
1 1 Front Aerodynamic Devices/FrontWing/Mold Files/FrontA/Body56.sldprt
1 1 Front Aerodynamic Devices/FrontWing/Mold Files/FrontA/Body57.sldprt
1 1 Front Aerodynamic Devices/FrontWing/Mold Files/FrontA/Body58.sldprt
1 1 Front Aerodynamic Devices/FrontWing/Mold Files/FrontA/Body59.sldprt
1 1 Front Aerodynamic Devices/FrontWing/Mold Files/FrontA/Body60.sldprt
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
