vishakhkumar/HyTechAero/(commit log)

2016-12-03 Initial commit. Added meeting notes, ideas, rules and Solidworks Files.
    [0 AERO ORDERS.xlsx, 0 BRING TO COMP LIST.xlsx, 1-16-16 Assembreeee.SLDASM, F16_AE_Assembly.SLDASM, F16_AE_CloseOuts.SLDPRT, F16_AE_FrontWing.SLDPRT, F16_AE_Nose.SLDPRT, F16_AE_RearWingAssembly.SLDASM]
2016-12-04 Added Airfoils Folder. Added Complex Airfoils folder. Added Complex Airfoil sld part along with design table.
    [ComplexAirfoil.SLDPRT, ComplexAirfoil__new.xlsx]
2016-12-04 Created Endplate sld file. Created design table along with it. Model appears to be stable when given small changes in parameters.
    [Endplate.SLDPRT, Endplate__new.xlsx]
2016-12-04 Endplate completed. Hopefully it won't break immediately.
    [Endplate.SLDPRT, Endplate__new.xlsx]
2016-12-04 Changed folder name from Endplate to FrontEndplate. I felt that was necessary to distinguish it from the real endplate (which is pretty much a flat plat.
    [Endplate.SLDPRT, Endplate__new.xlsx]
2016-12-04 Deleted unnecessary Seat Molds. New ones have been created and this does not belong to the Aerokit. If you require Seat Molds, it shall be best to contact Russell.
2016-12-04 Added slots to rear endplate. Made a reference of sorts with relations to the actual slots on the endplate - I wanted to avoid multiple dimensions on the same sketch mucking up my part.
    [RearEndPlate.SLDPRT]
2016-12-04 Added slot position and slot profile. Pausing development for now to work n other parts.
    [RearEndPlate.SLDPRT]
2016-12-05 Created new folder for aerodynamic devices near the driver. Added notes on what those aerodynamic devices might look like.
2016-12-05 Created endplate profile. Bunch of lines and ellipses everywhere.
    [RearEndPlate.SLDPRT]
2016-12-05 Deleted slot profile. Decided that dealing with slots at the end would be wiser. Saved slots in a seperate file - RearEndPlateWithSlots.
    [RearEndPlate.SLDPRT, RearEndPlateWithSlots.SLDPRT]
2016-12-05 Created 3-D endplate. Created two seperate endplate planes. Created a seperation and joined them together using boundary surface.
    [RearEndPlate.SLDPRT]
2016-12-05 Added color to surfaces and created a boundary box as visual aid. Knitted surfaces together.
    [RearEndPlate.SLDPRT]
2016-12-05 Converted endplate surface to solid. Achieved by creating a linear pattern and using boundary surfaces. Did not use thicken to avoid degradation of features.
    [RearEndPlate.SLDPRT, RearEndplates.SLDASM]
2016-12-05 Created assembly of rear endplates. Used a sketch to place read endplates. Outer extent becomes a bit tricky since the rear endplate is 3D and angled. When you create the wing, you might want to defi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
    [MirrorRearEndPlate.SLDPRT, RearEndPlate.SLDPRT, RearEndplates.SLDASM]
2016-12-05 Organised files better. Grouped relevant items together by adding numbers to folder names. Added folders for the parts that are to come. Added relevant papers.
    [0 AERO ORDERS.xlsx, 0 BRING TO COMP LIST.xlsx, 1-16-16 Assembreeee.SLDASM, ComplexAirfoil.SLDPRT, ComplexAirfoil__new.xlsx, Endplate.SLDPRT, Endplate__new.xlsx, F16_AE_Assembly.SLDASM]
2016-12-05 Added additional folder to aerodynamic devices.
2017-01-21 Deleted future version of the wing. Cannot open with 2016 version.
    [ComplexAirfoil.SLDPRT, ComplexAirfoil__new.xlsx]
2017-01-21 Added Benzing airfoil data and Generic Wing for future use. Thanks to Bishop for doing a bunch of hard work.
    [AirfoilData.xlsx, Be122-125.SLDPRT, Be122-155.SLDPRT, Be122-185.SLDPRT, Be153-055.SLDPRT, Be153-105.SLDPRT, Be153-175.SLDPRT, GenericWing.SLDPRT]
2017-01-21 Created front wing design for use by the rest of the team.
    [A.SLDPRT, B.SLDPRT, C.SLDPRT, FrontWingAssembly.SLDASM, MirrorB.SLDPRT, MirrorC.SLDPRT, RearWing.SLDPRT]
2017-01-25 Making a change for Connor. Change this V.
    [A.SLDPRT, B.SLDPRT, C.SLDPRT, FrontWingAssembly.SLDASM, GenericEndplate.SLDPRT, GenericEndplate.xlsx, GenericEndplate__new.xlsx, MirrorB.SLDPRT]
2017-01-29 New Endplate Configurations
    added several configurations to spreadsheet and edited .sldprt to add a
    feature for one of the endplates
    [GenericEndplate.SLDPRT, GenericEndplate.xlsx, GenericEndplate__new.xlsx, generic_endplate_save.xlsx]
2017-02-01 Endplate Surfaces
    completed endplates and added surfaces
    [GenericEndplate.SLDPRT, GenericEndplate.xlsx, generic_endplate_save.xlsx]
2017-02-05 Rearranged Folders of wings
    Rearranged folders of wings to prevent crosstalk. Each file has its own
    copy of required files.
    [A.SLDPRT, B.SLDPRT, C.SLDPRT, Endplate.SLDPRT, Endplate__new.xlsx, FrontWings.SLDASM, GenericEndplate.SLDPRT, GenericEndplate.xlsx]
2017-02-05 Created FrontEndplate Grungeplates and added to Front Assembly
    [A.SLDPRT, B.SLDPRT, C.SLDPRT, FrontAssembly.SLDASM, FrontEndplate.SLDPRT, FrontEndplateAssem.SLDASM, FrontWingAssem.SLDASM, FrontWings.SLDASM]
2017-02-05 Added Inner Endplate for support for side wings
    [C.SLDPRT, FrontAssembly.SLDASM, FrontEndplate.SLDPRT, FrontEndplateAssem.SLDASM, FrontEndplateInner.SLDPRT, FrontWingAssem.SLDASM, GenericEndplate.xlsx, MirrorB.SLDPRT]
2017-02-05 Created RearEndplate Assembly
    Nothing special, just created the assembly
    [FrontAssembly.SLDASM, FrontEndplate.SLDPRT, FrontEndplateAssem.SLDASM, FrontEndplateInner.SLDPRT, FrontWingAssem.SLDASM, GenericEndplate.SLDPRT, GenericEndplate.xlsx, MirrorB.SLDPRT]
2017-02-05 Created RearAssem
    Added the RearEndplates and rear wings to the same assembly.
    [A.SLDPRT, B.SLDPRT, C.SLDPRT, RearAssem.SLDASM, RearEndplateAssem.SLDASM, RearWings.SLDASM]
2017-02-07 Fixed Bug issues with front and rear aerodynamic devices
    Took a bloody long time to figure out why the parts were not saving
    changes. Curse you, PDM. Why can't you accept files with the same
    name??!!
    [A.SLDPRT, Assem1.SLDASM, B.SLDPRT, C.SLDPRT, FrontA.SLDPRT, FrontAssembly.SLDASM, FrontB.SLDPRT, FrontC.SLDPRT]
2017-02-12 Made minor changes to rear endplates
    [FrontEndplate.SLDPRT, FrontEndplateAssem.SLDASM, FrontEndplateInner.SLDPRT, GenericEndplate.xlsx, MirrorFrontEndplate.SLDPRT, MirrorFrontEndplateInner.SLDPRT]
2017-02-12 Created first successful nose cone
    [Aerokit.SLDASM, Assem1.SLDASM, Assem2.SLDASM, F.FrameFinal 10-12-16.SLDPRT, Front Full Nose.SLDPRT, nosecone.SLDPRT]
2017-02-12 Created nosecone lofts
    Finally created nosecone lofts. Russell, this nosecone says hi!
    [Assem2.SLDASM, Front Full Nose.SLDPRT, nosecone.SLDPRT]
2017-02-12 Created Mold Files
    Nabeel, look at this.
    [Aerokit.SLDASM, Body1.sldprt, Body10.sldprt, Body11.sldprt, Body12.sldprt, Body13.IGS, Body13.sldprt, Body14.sldprt]
2017-02-15 Created Close out mold
    Created flanges to assist in manufacturing and making the mold
    [AssemForRightCloseoutMold.SLDASM, AssemblyForCloseoutMold.SLDASM, Close Outs Right.SLDPRT, Close Outs2.SLDPRT, Part1.SLDPRT, box.SLDPRT]
2017-02-16 Modified NoseCone to make all edges laminar
    This was to ensure that no sharp edges could create vortices. Also
    checked minimum curvature of surface.
    [Aerokit.SLDASM, Front Full Nose.SLDPRT, noseconeassm.SLDASM]
2017-02-16 Created Nosecone Mold files. Again.
    Needed to fix mold files.
    [Aerokit.SLDASM, Body1.sldprt, Body10.sldprt, Body11.sldprt, Body12.sldprt, Body13.IGS, Body13.sldprt, Body14.sldprt]
2017-02-16 Renamed folder to more appropiate name.
    [Aerokit.SLDASM, NoseCone.SLDPRT]
2017-02-16 Revert "Renamed folder to more appropiate name."
    This reverts commit dbcae2956b09f001ec56e9b4febe05d62ec49951.
    [Aerokit.SLDASM, NoseCone.SLDPRT]
2017-02-16 Created Working Undertray,
    Booyah.
    [F.FrameFinal 10-12-16.SLDPRT, Undertray.SLDPRT, UndertrayAssem.SLDASM]
2017-02-17 Added close Out Mold
    Please fix the last mold, future V. I'm sorry about that.
    [closeoutmold.SLDPRT]
2017-02-19 Made Changes to nosecone to make it easier to manufacture.
    [Aerokit.SLDASM, NoseCone.SLDPRT, NoseConeAssembly.SLDASM]
2017-02-19 Created Undertray.
    [F.FrameFinal 10-12-16.SLDPRT, Undertray.SLDPRT, UndertrayAssem.SLDASM]
2017-02-19 Created mold Files for FrontA
    [Aerokit.SLDASM, Body1.sldprt, Body10.sldprt, Body11.sldprt, Body12.sldprt, Body13.sldprt, Body14.sldprt, Body15.sldprt]
2017-02-19 Created Mold Files for Front Wings
    [Aerokit.SLDASM, Body1.sldprt, Body10.sldprt, Body11.sldprt, Body12.sldprt, Body13.sldprt, Body14.sldprt, Body15.sldprt]
2017-02-21 Added Mold Files for Rear Wing
    Thanks a lot, Bishop
    [Aerokit.SLDASM, Body1.sldprt, Body10.sldprt, Body11.sldprt, Body12.sldprt, Body13.sldprt, Body14.sldprt, Body15.sldprt]
2017-02-21 Moved Old mold files to where they belonged and introduced new mold files.
    [Body1.sldprt, Body10.sldprt, Body11.sldprt, Body12.sldprt, Body13.sldprt, Body14.sldprt, Body15.sldprt, Body16.sldprt]
2017-02-21 Added Bill of Materials
    [Bill of Materials.xlsx]
